iridia-ulb/drone-pcb/manufacturing/May2021/drone-bill-of-materials.xlsx

Part | Value | Device | Package | Description | Description2 | Qty | Place_YES/NO | Povided_by_customer_YES/NO | Distributor | Ordernumber | Weblink | Remarks_customer | Unit_price | Total_price | REMARKS_BETA | OPTION1 | OPTION2 | OPTION3
U13 | - | SN74LV4T125PWR | 14-TSSOP | Integrated Circuit | - | 1 | YES | NO | Digikey | 296-40545-1-ND
U9 | - | MIC803-30D4VM3-TR | SOT-23-3 | Integrated Circuit | - | 1 | YES | NO | Digikey | 576-3812-1-ND
X1 | 25 MHz | ASCO-25.000MHZ-EK-T3 | - | Integrated Circuit | - | 1 | YES | NO | Digikey | 535-12075-1-ND
U1 | - | USB4715T-I/Y9X | 48-VQFN | Integrated Circuit | - | 1 | YES | NO | Digikey | USB4715T-I/Y9XCT-ND
C70,C47,C46,C45,C44,C43,C38,C37,C35,C1,C2,C40,C39,C41,C61,C58,C3,C57,C59,C60,C21,C20,C19,C49,C69,C68,C66,C65,C48,C15,C50,C13,C11,C9,C7 | 100n | Generic | C0805 | Chip Capacitor | - | 35 | YES | NO | BetaLAYOUT stock | 100n, 50V, X7R
Q10,Q3,Q11,Q7,Q9,Q4,Q8,Q2,Q6,Q5,Q1 | - | BSS138DWQ-7 | SOT363 | MOSFET | - | 11 | YES | NO | Digikey | BSS138DWQ-7DICT-ND
R2,R44,R43,R40,R1,R81,R80,R4,R76,R75,R29,R34,R30,R31,R32,R33,R3,R5,R6,R7,R8,R63,R65,R12,R10,R16,R14,R46,R61,R15,R13,R11,R9,R38,R36 | 10k | Generic | R0805 | Chip Resistor | - | 35 | YES | NO | BetaLAYOUT stock | 10k, 1%
R84,R83,R82 | 4k7 | Generic | R0805 | Chip Resistor | - | 3 | YES | NO | BetaLAYOUT stock | 4k7, 1%
R42,R41,R37 | 200k | Generic | R0805 | Chip Resistor | - | 3 | YES | NO | BetaLAYOUT stock | 200k, 1%
R39 | 12k,1% | Generic | R0805 | Chip Resistor | - | 1 | YES | NO | BetaLAYOUT stock | 12k, 1%
FB1 | 120R | MMZ2012R121AT000 | R0805 | Ferrite Bead | - | 1 | YES | NO | Digikey | 445-2190-1-ND
C36,C34,C62,C31,C55,C54,C5,C4,C18,C17,C16,C28,C53,C52,C26,C24,C33,C27,C30,C29,C32,C23,C25,C67,C64,C63,C22 | 1u | Generic | C0805 | Chip Capacitor | - | 27 | YES | NO | BetaLAYOUT stock | 1u, 25V, X7R
U10 | - | TPS2054BD | 16-SOIC | Integrated Circuit | - | 1 | YES | NO | Digikey | 296-34586-5-ND
J16,J12,J8,J4 | - | SM05B-SRSS-TB(LF)(SN) | - | Header | - | 4 | YES | NO | Digikey | 455-1805-1-ND
U2 | - | PCA9554D,118 | 16-SOIC | Integrated Circuit | - | 1 | YES | NO | Digikey | 568-11911-1-ND
C42,C56,C6,C51,C14,C12,C10,C8 | 10u | Generic | C0805 | Chip Capacitor | - | 8 | YES | NO | BetaLAYOUT stock | 10u, 16V, X5R
R79,R77 | 6k8 | Generic | R0805 | Chip Resistor | - | 2 | YES | NO | BetaLAYOUT stock | 6k8, 1%
R78,R45 | 5k6 | Generic | R0805 | Chip Resistor | - | 2 | YES | NO | BetaLAYOUT stock | 5k6, 1%
D16 | Orange | APT3216SECK | - | SMD LED | - | 1 | YES | NO | Digikey | 754-1140-1-ND
D15 | Yellow | APT3216SYCK | - | SMD LED | - | 1 | YES | NO | Digikey | 754-1144-1-ND
D17 | Green | APT3216ZGC | - | SMD LED | - | 1 | YES | NO | Digikey | 754-1440-1-ND
D14 | Blue | APT3216VBC/D | - | SMD LED | - | 1 | YES | NO | Digikey | 754-1799-1-ND
D13 | Red | APTR3216SECK/J3-PRV | - | SMD LED | - | 1 | YES | NO | Digikey | 754-APTR3216SECK/J3-PRVCT-ND
U16 | - | CMX60D20 | - | Relay | - | 1 | YES | NO | Mouser | 558-CMX60D20
P1 | - | AXK5S00347YG | - | Socket | - | 1 | YES | NO | Digikey | 255-4198-1-ND
U18 | - | NPPC062KFMS-RC | - | Header | - | 1 | YES | NO | Digikey | S5715-ND
J17 | - | SM06B-GHS-TB(LF)(SN) | - | Header | - | 1 | YES | NO | Digikey | 455-1568-1-ND
S1 | - | ES02MSABE | - | Switch | - | 1 | YES | NO | Digikey | CKN1813CT-ND
R58,R56,R74,R73,R55,R53,R51,R60,R54,R57,R59,R50,R52,R72,R71,R70,R69,R49 | 0R | Generic | R0805 | Chip Resistor | - | 18 | YES | NO | BetaLAYOUT stock | 0, 1%
J18 | - | XT60-F | - | Connector | - | 1 | YES | NO | TME | XT60-F | https://www.tme.eu/en/details/xt60-f/dc-power-connectors/amass/
J20A,J20B | - | NPPN101BFLC-RC | - | Header | - | 2 | YES | NO | Digikey | S5901-10-ND
D12,D9,D6,D3 | Red | C503B-RAN-CZ0C0AA1 | - | Through-hole LED | - | 4 | YES | NO | Digikey | C503B-RAN-CZ0C0AA1-ND
D11,D8,D5,D2 | Green | C503B-GAN-CB0F0791 | - | Through-hole LED | - | 4 | YES | NO | Digikey | C503B-GAN-CB0F0791-ND
D10,D7,D4,D1 | Blue | C503B-BAN-CY0C0461 | - | Through-hole LED | - | 4 | YES | NO | Digikey | C503B-BAN-CY0C0461-ND
J9,J15,J14,J13,J11,J10,J7,J6,J5,J3,J2,J1 | - | 7-188275-8 | - | Receptacle | - | 12 | YES | NO | Digikey | A99475CT-ND
U3 | - | 24LC32AF-I/SN | 8-SOIC | Integrated Circuit | - | 1 | YES | NO | Digikey | 24LC32AF-I/SN-ND
R68 | 100k | Generic | R0805 | Chip Resistor | - | 1 | YES | NO | BetaLAYOUT stock | 100k, 1%
J19 | - | XT90PW-M | - | Connector | - | 1 | YES | NO | TME | XT90PW-M | https://www.tme.eu/en/details/xt90pw-m/dc-power-connectors/amass/
R20,R27,R26,R24,R23,R21,R18,R17 | 100R | Generic | R0805 | Chip Resistor | - | 8 | YES | NO | BetaLAYOUT stock | 100, 1%
U5 | - | PCA9635PW/Q900,118 | 28-TSSOP | Integrated Circuit | - | 1 | YES | NO | Digikey | 568-5930-1-ND
U17 | - | TLV70218DBVT | SOT-23-5 | Integrated Circuit | - | 1 | YES | NO | Digikey | 296-27889-1-ND
U4 | - | SN74LVC2G14DBVRG4 | SOT-23-6 | Integrated Circuit | - | 1 | YES | NO | Digikey | 296-35955-1-ND
SW2,SW1 | - | B3FS-1012P | - | Push button | - | 2 | YES | NO | Digikey | SW1237CT-ND
R47 | 15.4k | Generic | R0805 | Chip Resistor | - | 1 | YES | NO | Digikey | 311-15.4KCRCT-ND
U8,U7,U6 | - | PCA9544ADWR | 20-SOIC | Integrated Circuit | - | 3 | YES | NO | Digikey | 296-20958-6-ND
R64,R66 | 130R | Generic | R0805 | Chip Resistor | - | 2 | YES | NO | BetaLAYOUT stock | 130, 1%
R67 | 18R | Generic | R0805 | Chip Resistor | - | 1 | YES | NO | BetaLAYOUT stock | 18, 1%
U15 | - | TLV75528PDBV | SOT-23-5 | Integrated Circuit | - | 1 | YES | NO | Digikey | 296-51798-1-ND
U20,U19 | - | NC7SZ157P6X | SC-88 | Integrated Circuit | - | 2 | YES | NO | Digikey | NC7SZ157P6XCT-ND
R48 | 120R | Generic | R0805 | Chip Resistor | - | 1 | YES | NO | BetaLAYOUT stock | 120, 1%
R62 | 30R | Generic | R0805 | Chip Resistor | - | 1 | YES | NO | Digikey | RMCF0805FT30R0CT-ND
U12 | - | AP2281-3WG-7 | SOT-26 | Integrated Circuit | - | 1 | YES | NO | Digikey | AP2281-3WG-7DICT-ND
R28,R25,R22,R19 | 147R | Generic | R0805 | Chip Resistor | - | 4 | YES | NO | Digikey | 311-147CRCT-ND
U14 | - | NPPC051KFXC-RC | - | Header | - | 1 | YES | NO | Digikey | S5636-ND
