iridia-ulb/drone-pcb/manufacturing/March2020/BOM.xlsx

Part | Value | Device | Package | Description | Description2 | Qty | Place_YES/NO | Povided_by_customer_YES/NO | Distributor | Ordernumber | Weblink | Remarks_customer | Unit_price | Total_price | REMARKS_BETA | OPTION1 | OPTION2 | OPTION3
C2 C60 C1 C57 C59 C58 C62 C61 C3 C7 C9 C11 C13 C15 C21 C20 C19 C34 C41 C39 C40 C35 C43 C50 C48 C49 C44 C66 C65 C68 C69 | 100n, 50V, Z5U | Generic | C0805 | Chip Capacitor | - | 4 | YES | NO | BetaLayout Stock | 100n, 50V, Z5U
C36 C45 | 1n, 50V, C0G | Generic | C0805 | Chip Capacitor | - |  | YES | NO | BetaLayout Stock | 1n, 50V, C0G
C37 C46 | 4u7, 25V, X5R | Generic | C0805 | Chip Capacitor | - | 4 | YES | NO | BetaLayout Stock | 4u7, 25V, X5R
C5 C4 C24 C27 C30 C33 C23 C26 C29 C32 C22 C25 C28 C31 C18 C17 C16 C38 C47 C55 C54 C53 C52 C67 C64 C63 | 1u, 25V, X7R | Generic | C0805 | Chip Capacitor | - | 4 | YES | NO | BetaLayout Stock | 1u, 25V, X7R
C6 C56 C8 C10 C12 C14 C42 C51 | 10u, 16V, X5R | Generic | C0805 | Chip Capacitor | - | 4 | YES | NO | BetaLayout Stock | 10u, 16V, X5R
D1 D4 D7 D10 | Blue | C503B-BAN-CY0C0461 | - | Through-hole LED | - | 4 | YES | NO | Digikey | C503B-BAN-CY0C0461-ND
D13 | Red | APT3216SECK/J3-PRV | - | SMD LED | - | 4 | YES | NO | Digikey | 754-1796-1-ND
D14 | Blue | APT3216VBC/D | - | SMD LED | - | 4 | YES | NO | Digikey | 754-1799-1-ND
D15 | Yellow | APT3216SYCK | - | SMD LED | - | 4 | YES | NO | Digikey | 754-1144-1-ND
D16 | Orange | APT3216SECK | - | SMD LED | - | 4 | YES | NO | Digikey | 754-1140-1-ND
D17 | Green | APT3216ZGC | - | SMD LED | - | 4 | YES | NO | Digikey | 754-1440-1-ND
D2 D5 D8 D11 | Green | C503B-GAN-CB0F0791 | - | Through-hole LED | - | 4 | YES | NO | Digikey | C503B-GAN-CB0F0791-ND
D3 D6 D9 D12 | Red | C503B-RAN-CZ0C0AA1 | - | Through-hole LED | - | 4 | YES | NO | Digikey | C503B-RAN-CZ0C0AA1-ND
J1 J2 J3 J5 J6 J9 J10 J11 J13 J14 J15 J7 | - | 7-188275-8 | - | Receptacle | - | 4 | YES | NO | Digikey | A99475CT-ND
J12 J16 J4 J8 | - | SM05B-SRSS-TB | - | Receptacle | - | 4 | YES | NO | Digikey | 455-1805-1-ND
J17 | - | SM06B-GHS-TB | - | Receptacle | - | 4 | YES | NO | Digikey | 455-1568-1-ND
J18 | - | XT60PW-F | - | Connector | - | 4 | YES | YES | Supplied | -
J19 | - | XT90PW-M | - | Connector | - | 4 | YES | YES | Supplied | -
J20A, J20B | - | Xbee | - | Connectors for Xbee | - | 4 | YES | NO | Digikey | S5901-10-ND
P1 | - | Up Core | - | Connector for Upboard | - | 4 | YES | NO | Digikey | 255-4198-1-ND
Q2 Q3 Q1 Q5 Q4 Q7 Q6 Q8 Q9 | - | BSS138DW | - | Transistor | - | 4 | YES | NO | Digikey | BSS138DWQ-7DICT-ND
R17 R18 R20 R21 R23 R24 R26 R27 | 100R | Generic | R0805 | Chip Resistor | - | 4 | YES | NO | BetaLayout Stock | 100R, 1%
R19 R22 R25 R28 | 147R | Generic | R0805 | Chip Resistor | - | 4 | YES | NO | Digkey | 311-147CRCT-ND
R39 R42 | 0R | Generic | R0805 | Chip Resistor | - | 4 | NO | NO | Not Applicable | - |  | Do not place
R4 R3 R6 R8 R5 R7 R1 R2 R14 R16 R10 R12 R13 R15 R9 R11 R38 R36 R31 R32 R33 R34 R29 R30 R41 R35 R44 R37 R46 R61 R65 R63 | 10k | Generic | R0805 | Chip Resistor | - | 4 | YES | NO | BetaLayout Stock | 10k, 1%
R45 R40 R43 | 12k | Generic | R0805 | Chip Resistor | - | 4 | YES | NO | BetaLayout Stock | 12k, 1%
R47 | 15.4k | Generic | R0805 | Chip Resistor | - | 4 | YES | NO | Digikey | 311-15.4KCRCT-ND
R48 | 120R | Generic | R0805 | Chip Resistor | - | 4 | YES | NO | BetaLayout Stock | 120R, 1%
R62 | 30R | Generic | R0805 | Chip Resistor | - | 4 | YES | NO | Digkey | RMCF0805FT30R0CT-ND
R64 R66 | 130R | Generic | R0805 | Chip Resistor | - | 4 | YES | NO | BetaLayout Stock | 130R, 1%
R67 | 18R | Generic | R0805 | Chip Resistor | - | 4 | YES | NO | BetaLayout Stock | 18R, 1%
R68 | 100k | Generic | R0805 | Chip Resistor | - | 4 | YES | NO | BetaLayout Stock | 100k, 1%
R73 R74 R49 R50 R51 R54 R53 R52 R55 R58 R56 R59 R60 R57 R69 R70 R71 R72 | 0R | Generic | R0805 | Chip Resistor | - | 4 | YES | NO | BetaLayout Stock | 0R, 1%
S1 | - | ES02MSABE | - | Switch | - | 4 | YES | NO | Digikey | CKN1813CT-ND
SW2 SW1 | - | B3FS-1012P | - | Switch | - | 4 | YES | NO | Digikey | SW1237CT-ND
U10 | - | TPS2054BDR | 16-SOIC | Integrated Circuit | - | 4 | YES | NO | Digikey | 296-16988-6-ND
U12 | - | AP2281 | SOT-23-6 | Integrated Circuit | - | 4 | YES | NO | Digikey | AP2281-3WG-7DICT-ND
U13 | - | TXB0104DR | 14-SOIC | Integrated Circuit | - | 4 | YES | NO | Digikey | 296-21928-1-ND
U14 | - | D36V28F3 | - | Connector for external module | - | 4 | YES | NO | Digikey | S5597-ND
U15 | - | TLV75528PDBV | SOT-23-5 | Integrated Circuit | - | 4 | YES | NO | Digikey | 296-51798-1-ND
U16 | - | CMX60D20 | - | Integrated Circuit | - | 4 | YES | NO | Digikey | CC1666-ND
U17 | - | TLV75518PDBV | SOT-23-5 | Integrated Circuit | - | 4 | YES | NO | Digikey | 296-50410-1-ND
U18 | - | D36V50F5 | - | Connector for external module | - | 4 | YES | NO | Digikey | S5715-ND
U19 U20 | - | NC7SZ157 | SC-88 (SC-70-6) | Integrated Circuit | - | 4 | YES | NO | Digikey | NC7SZ157P6XCT-ND
U2 U1 | - | PCA9554D,118 | SOIC-16 | Integrated Circuit | - | 4 | YES | NO | Digikey | 568-11911-1-ND
U3 | - | 24LC32AF | SOIC-8 | Integrated Circuit | - | 4 | YES | NO | Digikey | 24LC32AF-I/SN-ND
U4 | - | SN74LVC2G14 | SOT-23-6 | Integrated Circuit | - | 4 | YES | NO | Digikey | 296-13010-1-ND
U5 | - | PCA9635PW | TSSOP-28 | Integrated Circuit | - | 4 | YES | NO | Digikey | 568-4067-1-ND
U6 U7 U8 | - | PCA9544ADWR | SOIC-20 | Integrated Circuit | - | 4 | YES | NO | Digikey | 296-20958-6-ND
U9 U11 | - | USB3503 | SQFN-32 | Integrated Circuit | - | 4 | YES | NO | Digikey | USB3503T-I/MLCT-ND
X1 X2 | - | ASTXR-12 | - | Oscillator | - | 4 | YES | NO | Digikey | 535-13192-1-ND
N1 | - | PH2-12-UA | - | Header | - | 4 | NO | YES | Digikey | 2057-PH2-12-UA-ND |  | Please order and ship with PCBs
N2 | - | TSW-105-08-T-S | - | Header | - | 4 | NO | YES | Digikey | SAM1050-05-ND |  | Please order and ship with PCBs
N3, N4, N5, N6, N7 | - | 971100244 | - | Standoff | - | 4 | NO | YES | Digikey | 732-12918-ND |  | Please order and ship with PCBs
N8, N9, N10, N11 | - | 971100154 | - | Standoff | - | 4 | NO | YES | Digikey | 732-12917-ND |  | Please order and ship with PCBs
N12, N13, N14, N15, N16 | - | 16M02050080 | - | Washer | - | 4 | NO | YES | Digikey | RPC10276-ND |  | Please order and ship with PCBs
N17, N18, N19, N20 | - | 16M02556080 | - | Washer | - | 4 | NO | YES | Digikey | RPC10206-ND |  | Please order and ship with PCBs
N21, N22, N23, N24, N25 | - | 04M020040HN | - | Nut | - | 4 | NO | YES | Digikey | RPC7084-ND |  | Please order and ship with PCBs
N26, N27, N28, N29 | - | 04M025045HN | - | Nut | - | 4 | NO | YES | Digikey | RPC7085-ND |  | Please order and ship with PCBs
N30 | - | XB2B-WFUT-001 | - | External Module | - | 4 | NO | YES | Digikey | 602-1378-ND |  | Please order and ship with PCBs
N31 | - | WRL-11697 | - | External Module | - | 4 | NO | YES | Digikey | 1568-1116-ND |  | Please order and ship with PCBs
