iridia-ulb/drone-pcb/board-outline.dxf

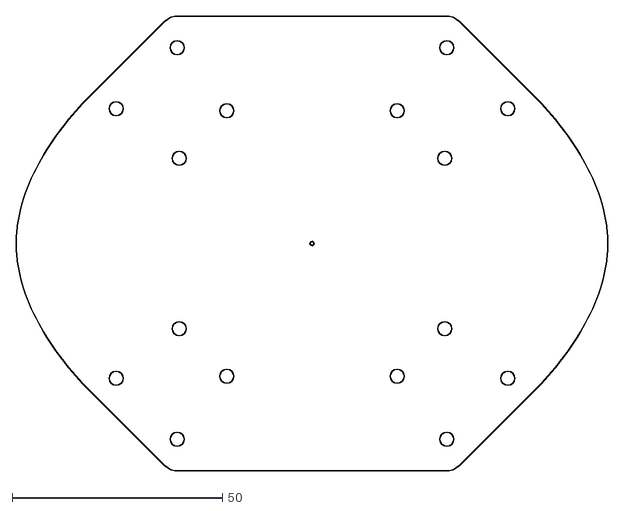
[picture p1: CAD file, 2020-02-24]
board-outline.dxf
140.6 x 108.1
