iridia-ulb/drone-pcb/models/asco.step

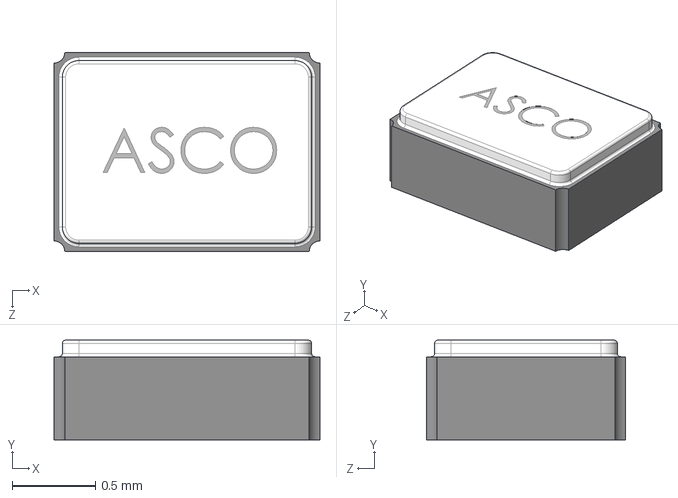
[picture p2: CAD file, 2021-05-06]
models/asco.step
1.60 x 0.6 x 1.20 mm
