iridia-ulb/drone-pcb/arms-outline.dxf

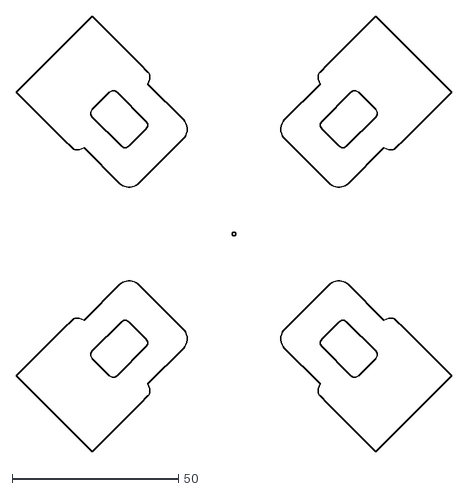
[picture p3: CAD file, 2020-02-24]
arms-outline.dxf
131.0 x 131.0
