iridia-ulb/drone-pcb/models/lower-components.step

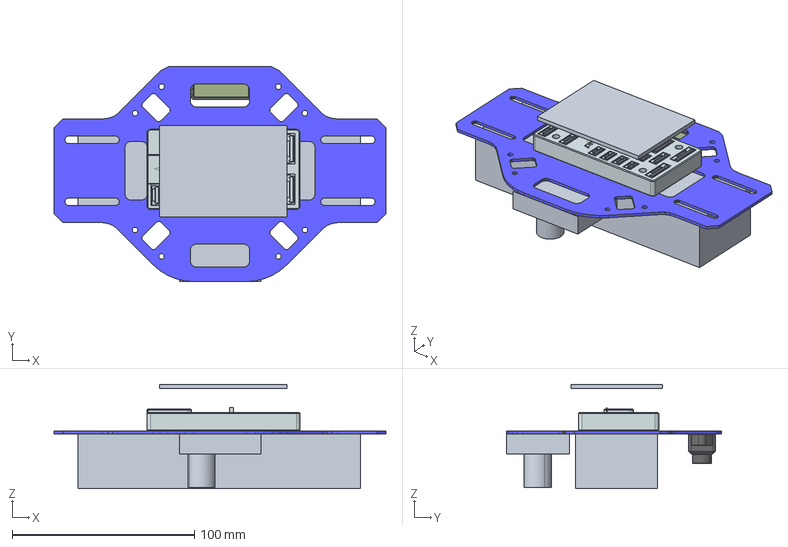
[picture p4: CAD file, 2020-03-05]
models/lower-components.step
182.0 x 118.1 x 57.0 mm
Block 15
Block 16
Block 17
Lente Grande
Lente Pequena
SM04B-GHS-TB
Chipset
Adesivo
Block 19
