iridia-ulb/drone-pcb/models/APT3216.step

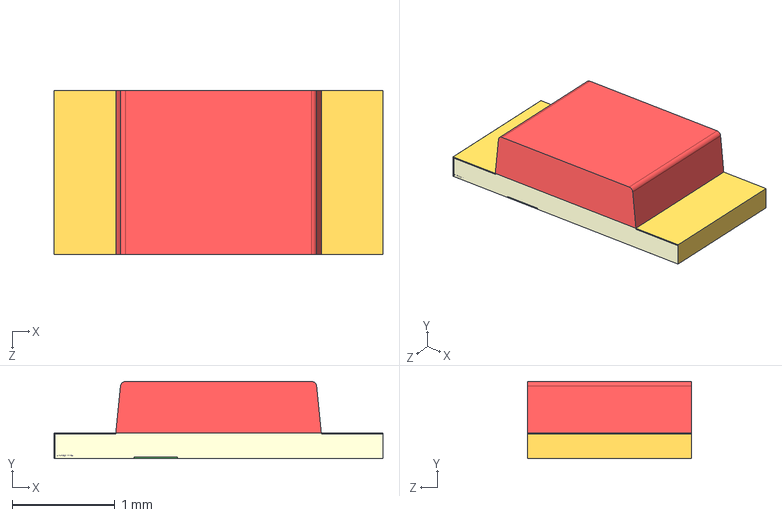
[picture p5: CAD file, 2020-03-03]
models/APT3216.step
3.20 x 0.75 x 1.60 mm
