iridia-ulb/drone-pcb/models/xbee.step

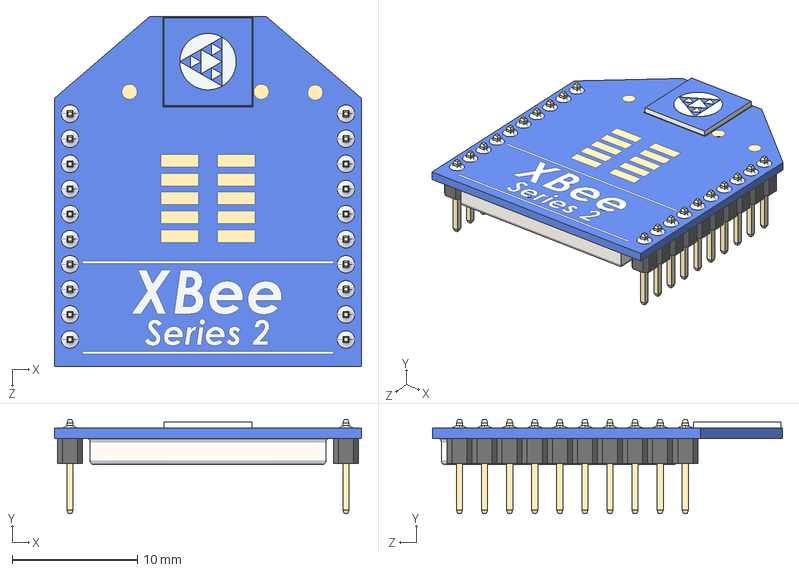
[picture p6: CAD file, 2020-02-28]
models/xbee.step
24.5 x 7.50 x 27.9 mm
XBee-10pin-male_1 x 2
XBee-Chip_1
XBee-Chip-antenna_1
