iridia-ulb/drone-pcb/models/NPPN101BFLC-RC.step

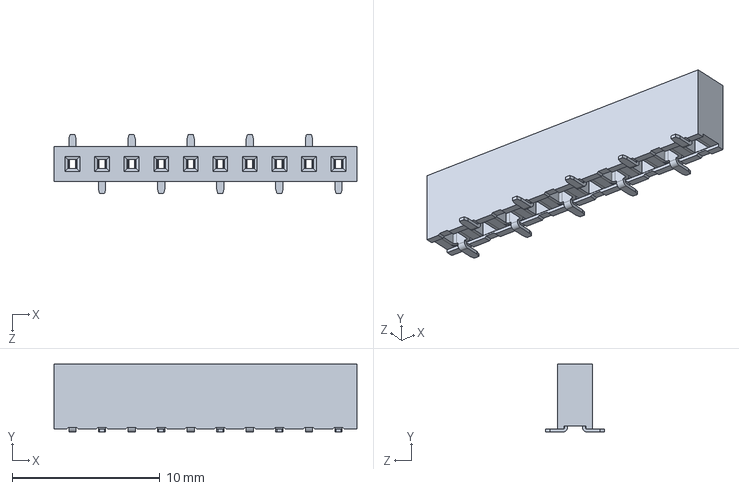
[picture p7: CAD file, 2020-02-28]
models/NPPN101BFLC-RC.step
20.5 x 4.60 x 4.00 mm
