iridia-ulb/drone-pcb/models/7-188275-8.step

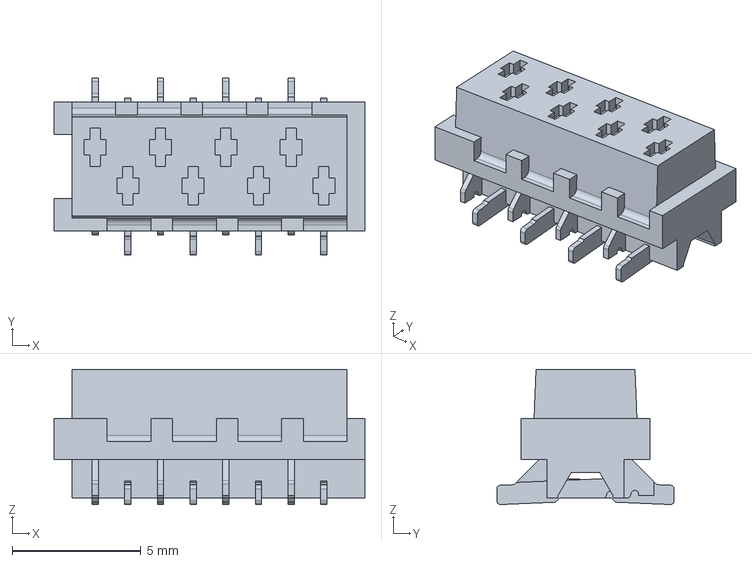
[picture p8: CAD file, 2020-02-25]
models/7-188275-8.step
12.1 x 6.90 x 5.25 mm
