iridia-ulb/drone-pcb/models/arms.step

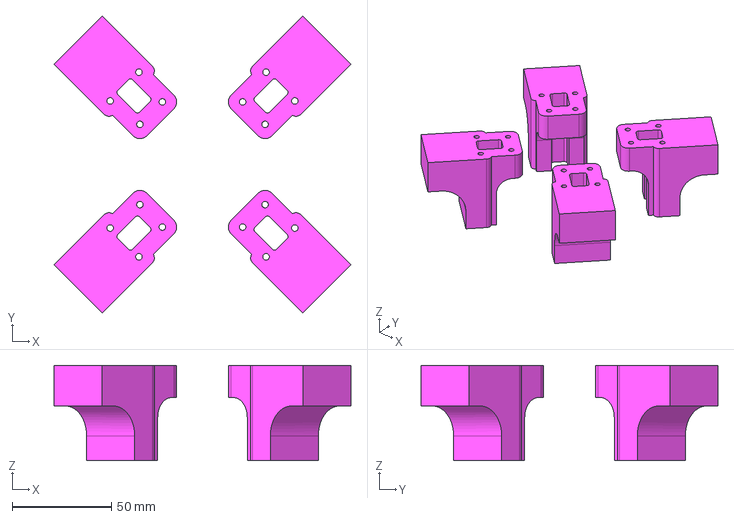
[picture p9: CAD file, 2020-02-24]
models/arms.step
149.6 x 149.6 x 48.0 mm
