iridia-ulb/drone-pcb/models/m2-spacer-10mm.step

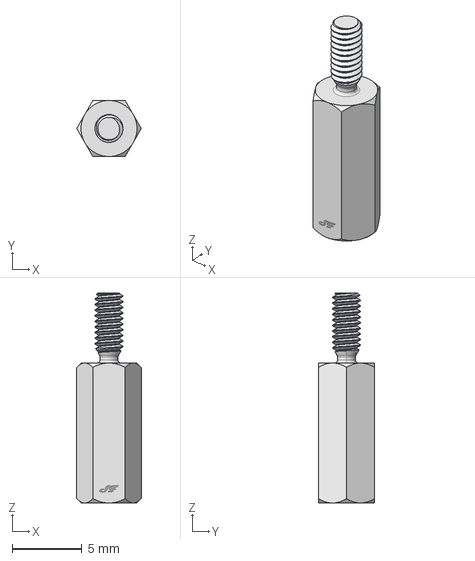
[picture p10: CAD file, 2020-02-21]
models/m2-spacer-10mm.step
4.62 x 4.00 x 15.0 mm
