iridia-ulb/drone-pcb/models/C503B.step

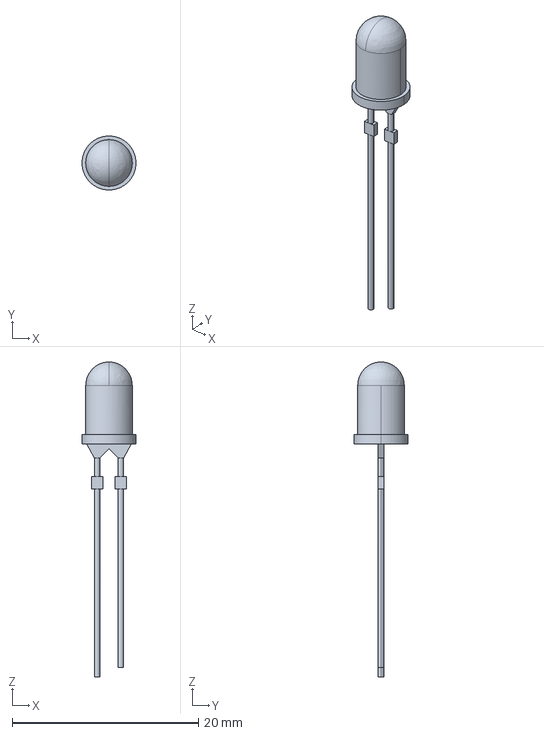
[picture p11: CAD file, 2020-02-19]
models/C503B.step
5.80 x 5.80 x 33.8 mm
