iridia-ulb/drone-pcb/models/sm07b-srss-tb.step

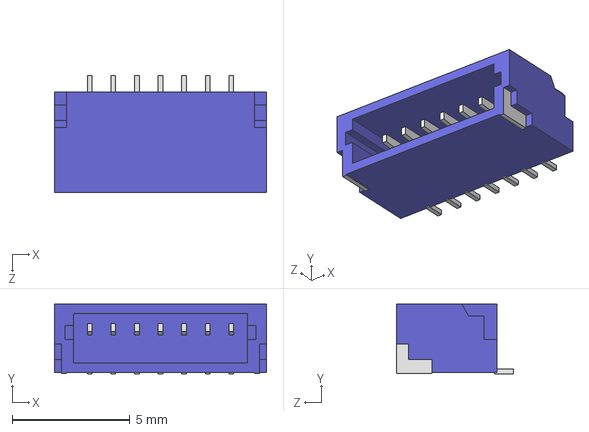
[picture p12: CAD file, 2020-02-18]
models/sm07b-srss-tb.step
9.00 x 2.96 x 4.95 mm
