iridia-ulb/drone-pcb/models/vl53l0x-and-vl53l1x-carrier-model.step

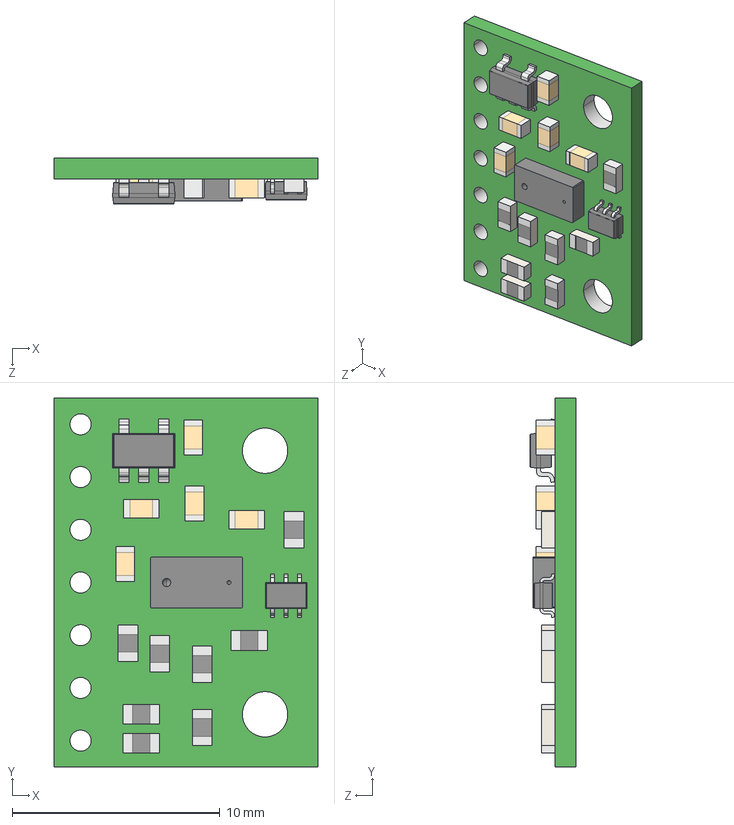
[picture p13: CAD file, 2020-02-18]
models/vl53l0x-and-vl53l1x-carrier-model.step
12.7 x 17.8 x 2.21 mm
