iridia-ulb/drone-pcb/models/m2.5hex9mm.stp

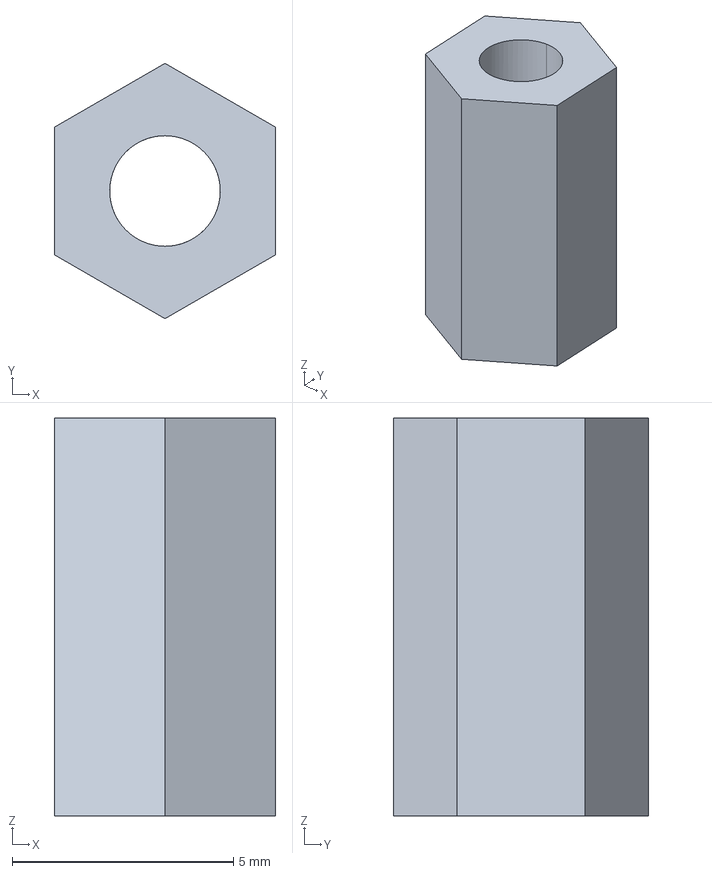
[picture p14: CAD file, 2020-02-18]
models/m2.5hex9mm.stp
5.00 x 5.77 x 9.00 mm
