iridia-ulb/drone-pcb/models/MSL04.step

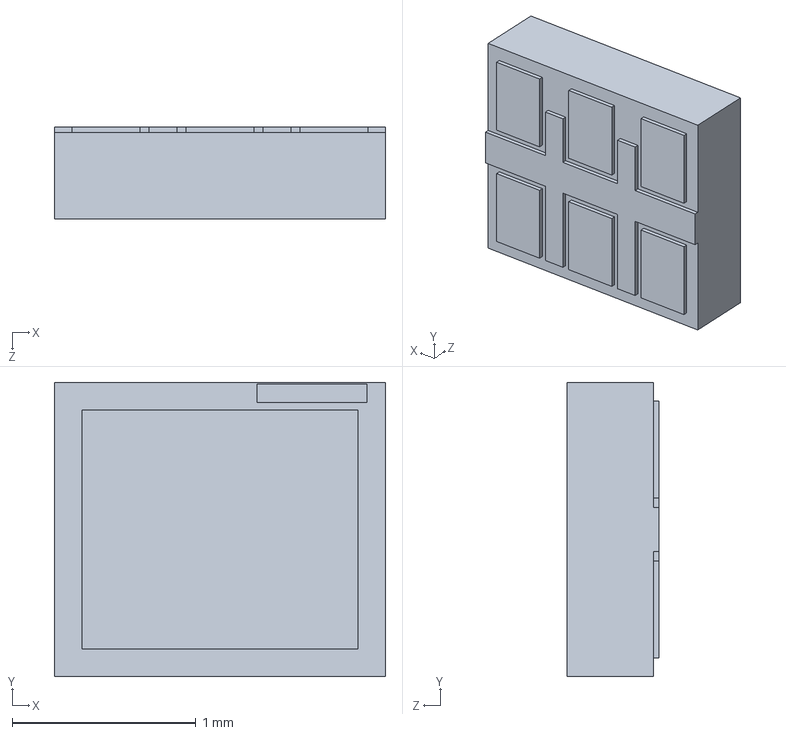
[picture p15: CAD file, 2020-02-14]
models/MSL04.step
1.80 x 1.60 x 0.5 mm
