iridia-ulb/drone-pcb/models/SM06B-GHS-TB.STEP

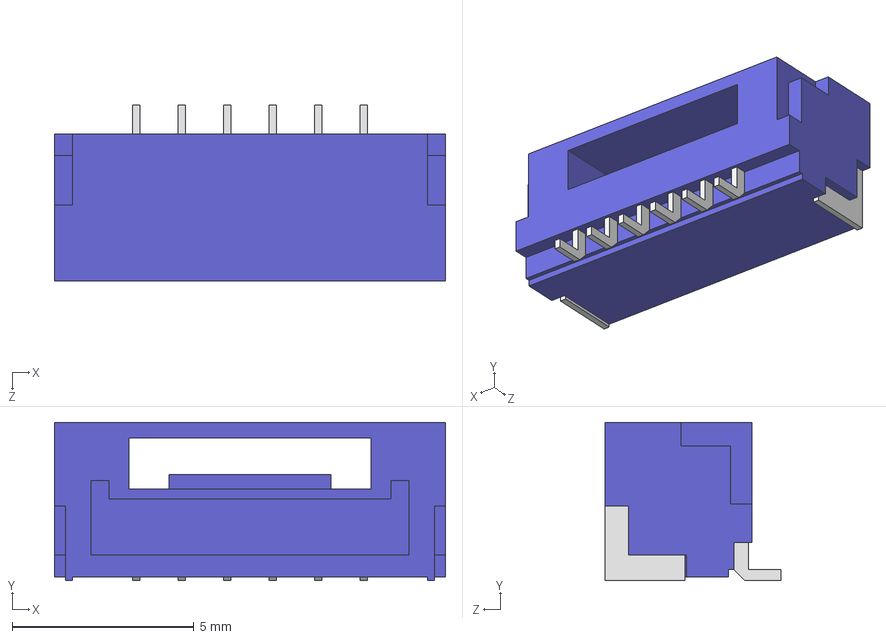
[picture p16: CAD file, 2020-02-13]
models/SM06B-GHS-TB.STEP
10.8 x 4.35 x 4.85 mm
