iridia-ulb/drone-pcb/models/BM06B-GHS-TBT.STEP

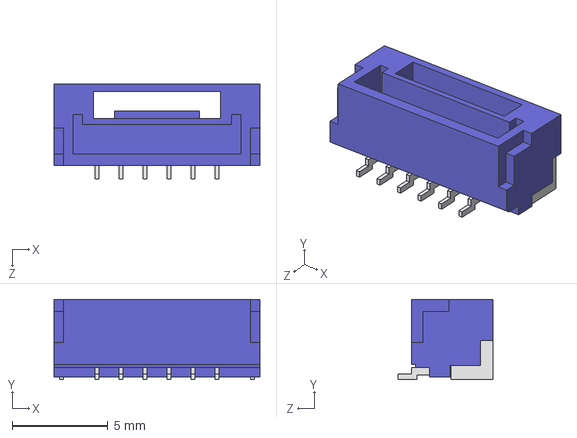
[picture p17: CAD file, 2020-02-13]
models/BM06B-GHS-TBT.STEP
10.8 x 4.20 x 4.95 mm
