iridia-ulb/drone-pcb/models/ES01MSABE.stp

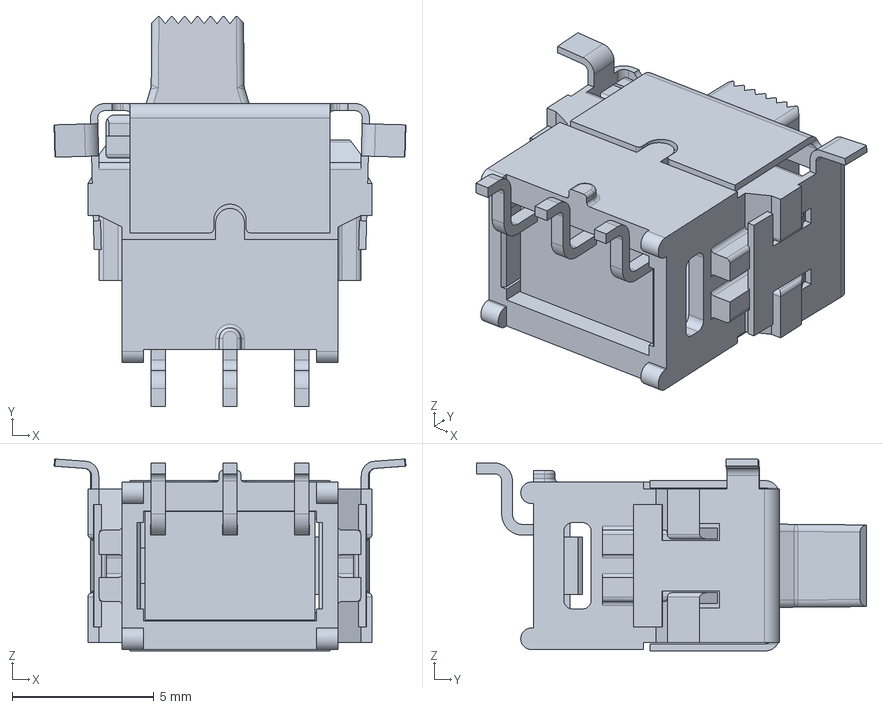
[picture p18: CAD file, 2020-02-12]
models/ES01MSABE.stp
12.4 x 13.8 x 6.78 mm
