iridia-ulb/drone-pcb/models/vertical-pin-socket-2x06.step

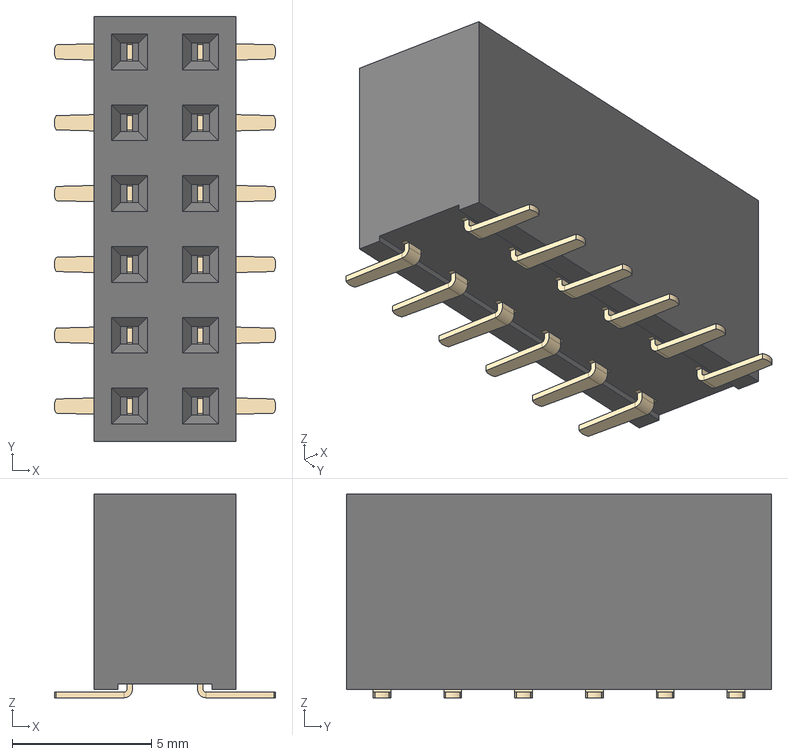
[picture p19: CAD file, 2020-02-11]
models/vertical-pin-socket-2x06.step
7.94 x 15.2 x 7.30 mm
