iridia-ulb/drone-pcb/models/vertical-pin-header-1x05.step

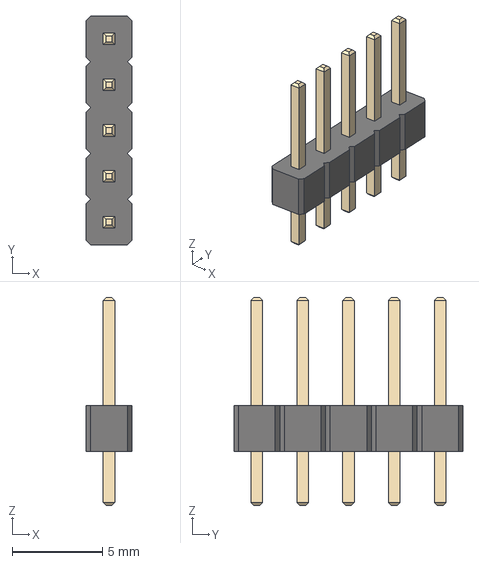
[picture p20: CAD file, 2020-02-11]
models/vertical-pin-header-1x05.step
2.54 x 12.7 x 11.5 mm
