iridia-ulb/drone-pcb/models/vertical-pin-socket-1x05.step

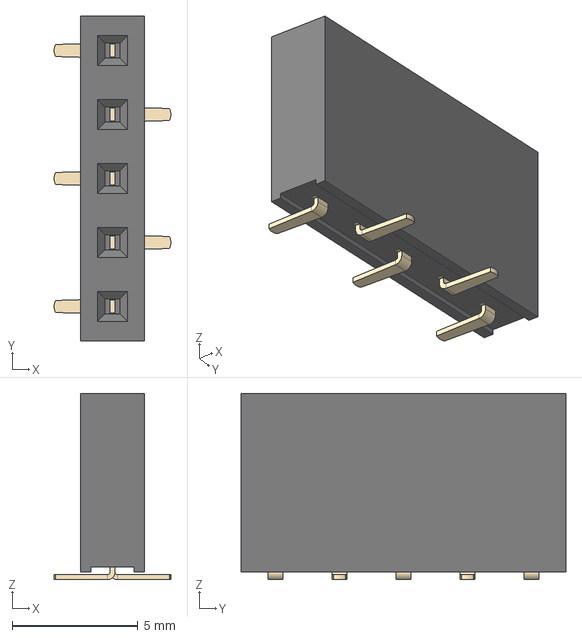
[picture p21: CAD file, 2020-02-11]
models/vertical-pin-socket-1x05.step
4.64 x 12.9 x 7.40 mm
