iridia-ulb/drone-pcb/models/vertical-pin-header-2x06.step

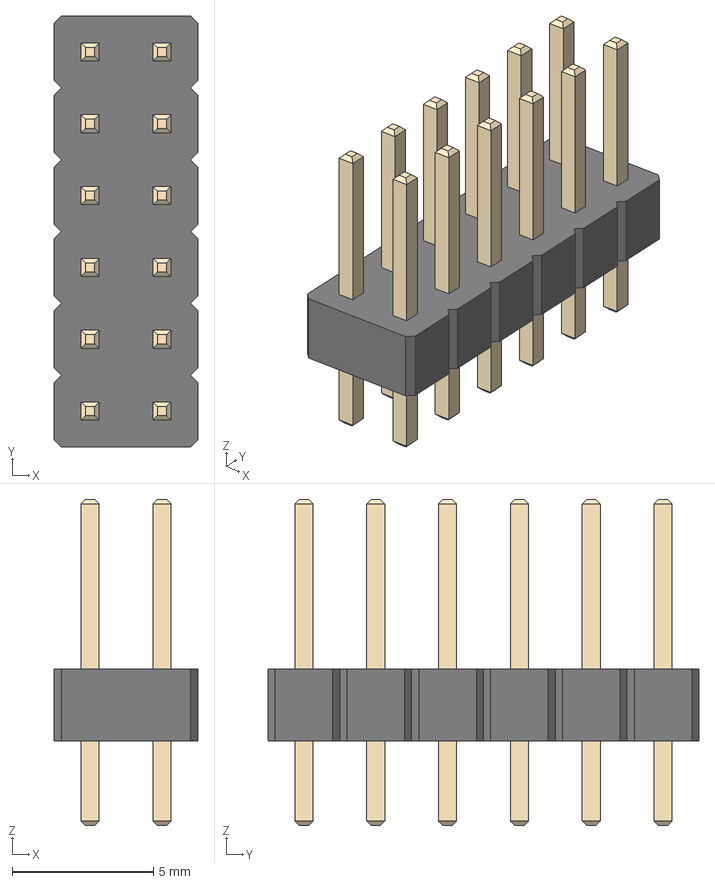
[picture p22: CAD file, 2020-02-11]
models/vertical-pin-header-2x06.step
5.08 x 15.2 x 11.5 mm
