iridia-ulb/drone-pcb/models/B3FS_1000.step

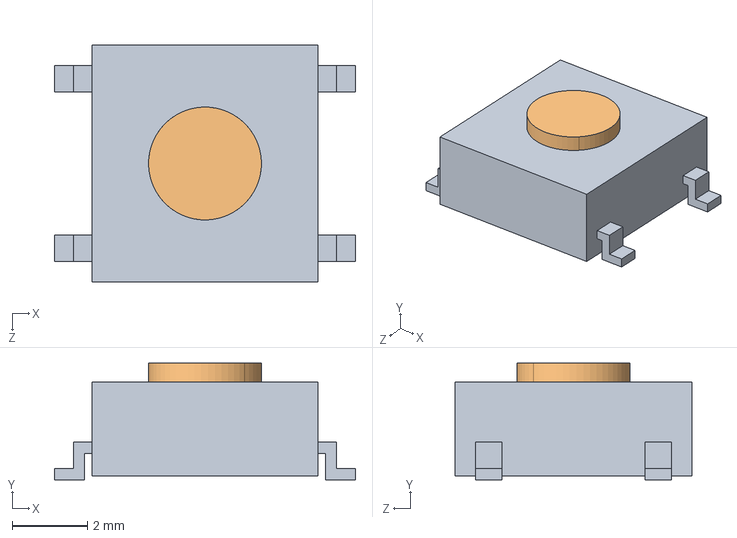
[picture p23: CAD file, 2020-02-10]
models/B3FS_1000.step
8.00 x 3.10 x 6.30 mm
B3FS_1000_BASE
B3FS_1000_BUTTON
