iridia-ulb/drone-pcb/models/axk5s00347y.stp

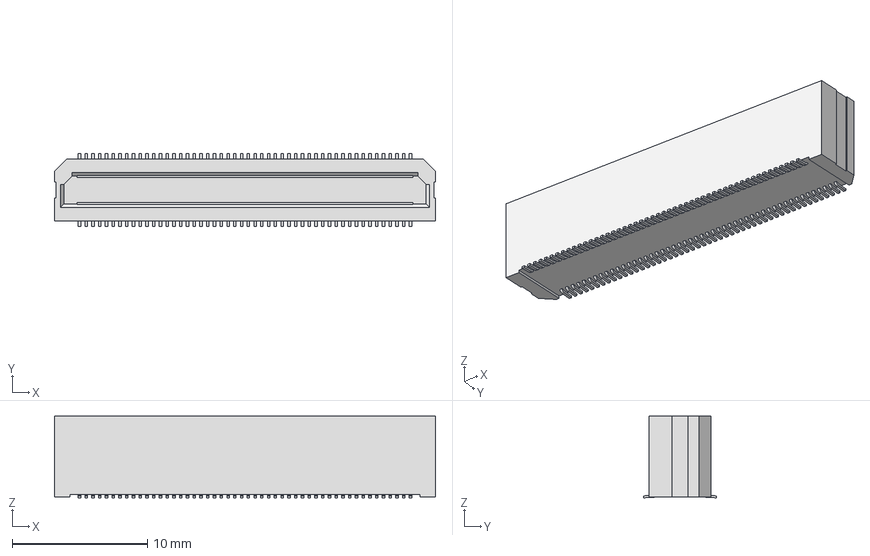
[picture p24: CAD file, 2020-02-10]
models/axk5s00347y.stp
28.2 x 5.40 x 6.05 mm
