iridia-ulb/drone-pcb/models/XT90PW-M.step

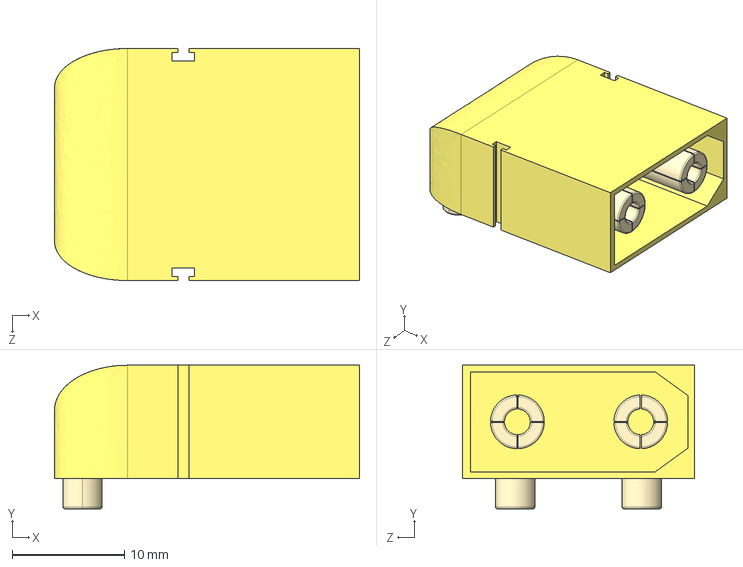
[picture p25: CAD file, 2020-02-05]
models/XT90PW-M.step
27.2 x 12.8 x 20.7 mm
