iridia-ulb/drone-pcb/models/CMX60D20.step

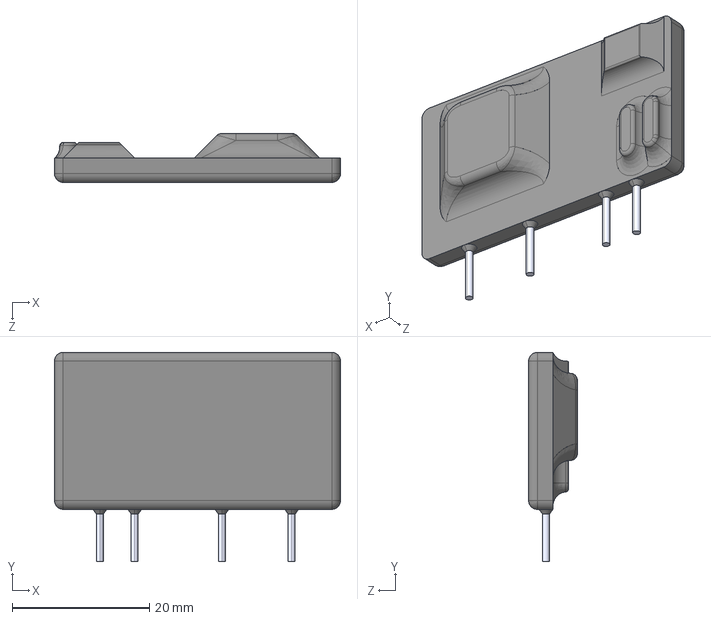
[picture p26: CAD file, 2020-02-05]
models/CMX60D20.step
41.7 x 30.5 x 7.11 mm
