iridia-ulb/drone-pcb/models/XT60-F.step

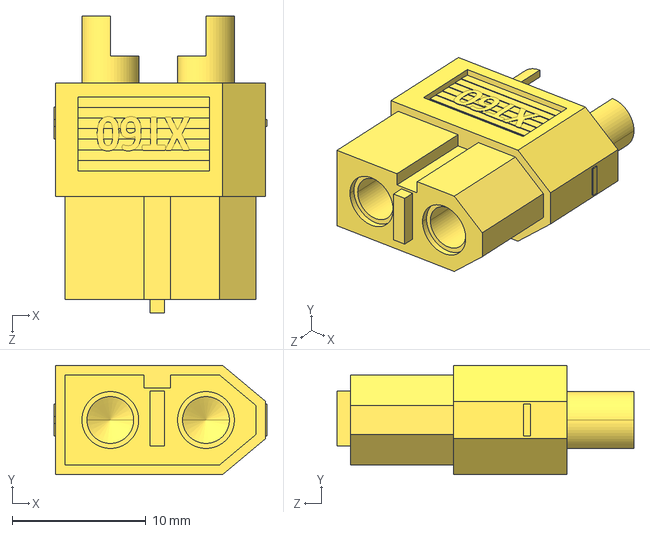
[picture p27: CAD file, 2020-02-05]
models/XT60-F.step
15.9 x 8.15 x 22.2 mm
