iridia-ulb/drone-pcb/models/sm05b-srss-tb.step

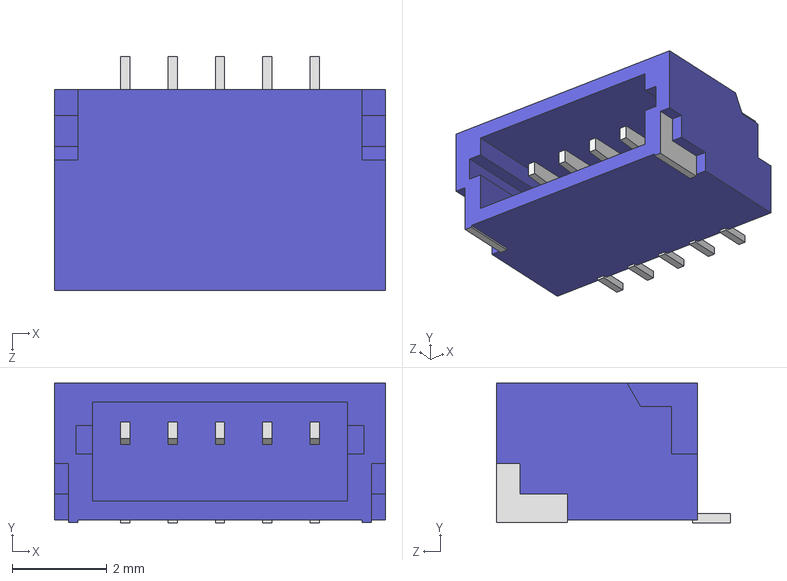
[picture p28: CAD file, 2020-01-28]
models/sm05b-srss-tb.step
7.00 x 2.96 x 4.95 mm
