iridia-ulb/drone-pcb/models/astxr-12.step

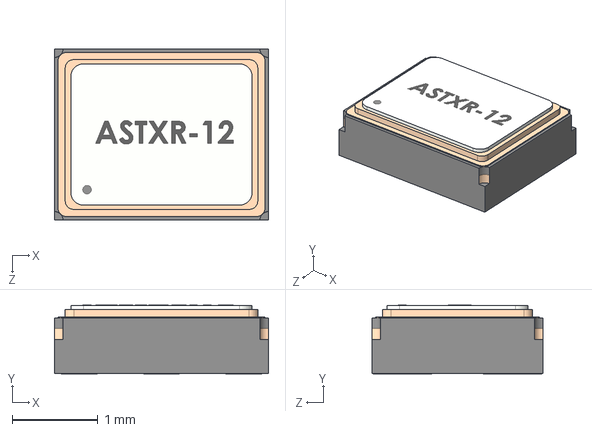
[picture p29: CAD file, 2020-01-28]
models/astxr-12.step
2.50 x 0.802 x 2.00 mm
