iridia-ulb/drone-pcb/(list of files, cad)

Other CAD files:
models/ES02MSABE.stp
models/bolt-assembly.step
