iridia-ulb/drone-pcb/manufacturing/May2021/drone-assembly-drawing-back.pdf

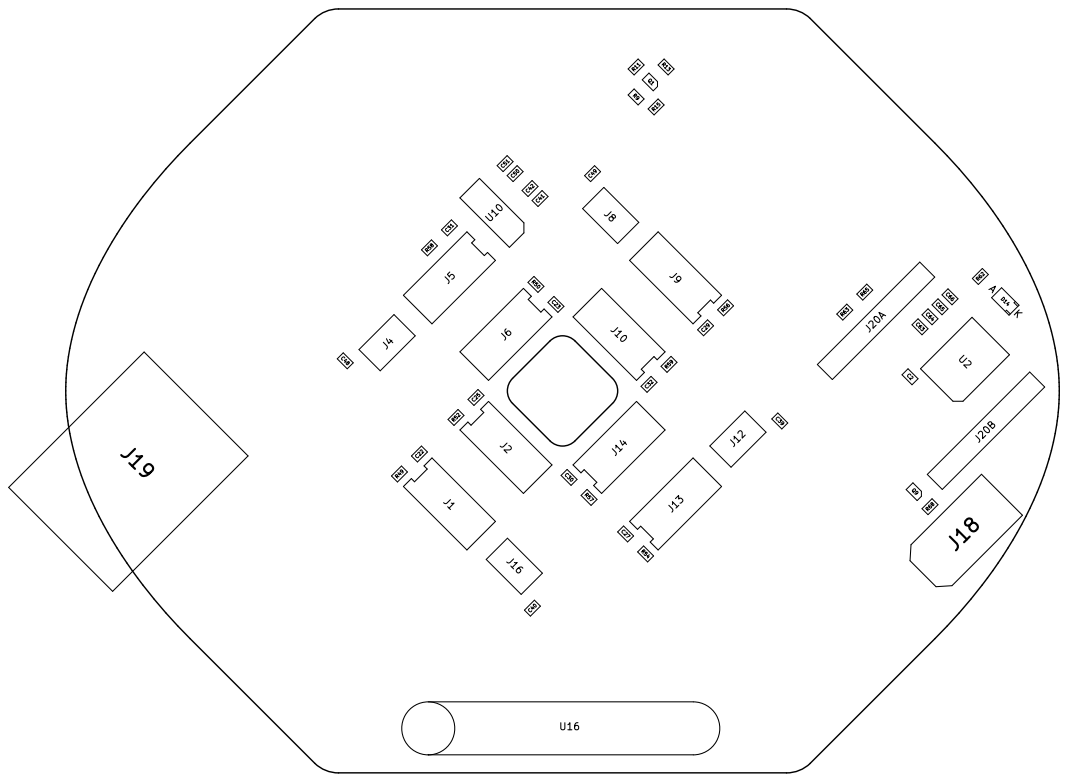
[picture p30: page 1]
