iridia-ulb/drone-pcb/manufacturing/May2021/drone-assembly-drawing-front.pdf

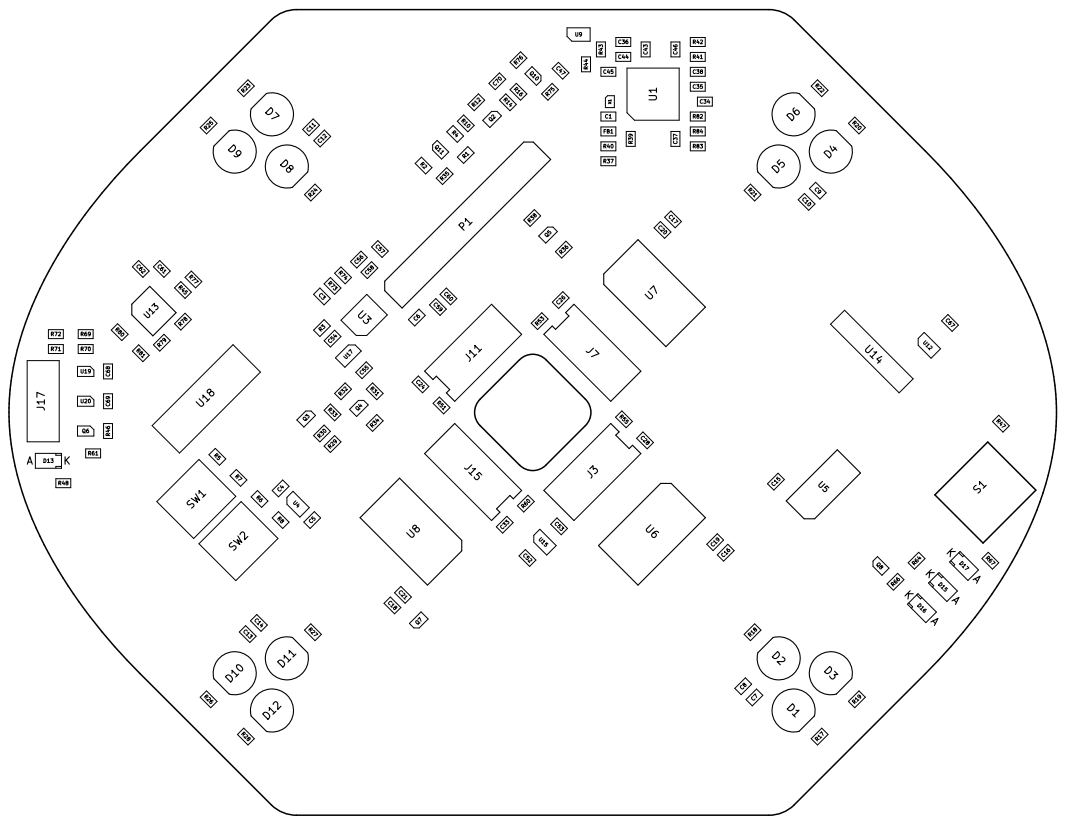
[picture p31: page 1]
