iridia-ulb/drone-pcb/manufacturing/March2020/assembly-drawing-back.pdf

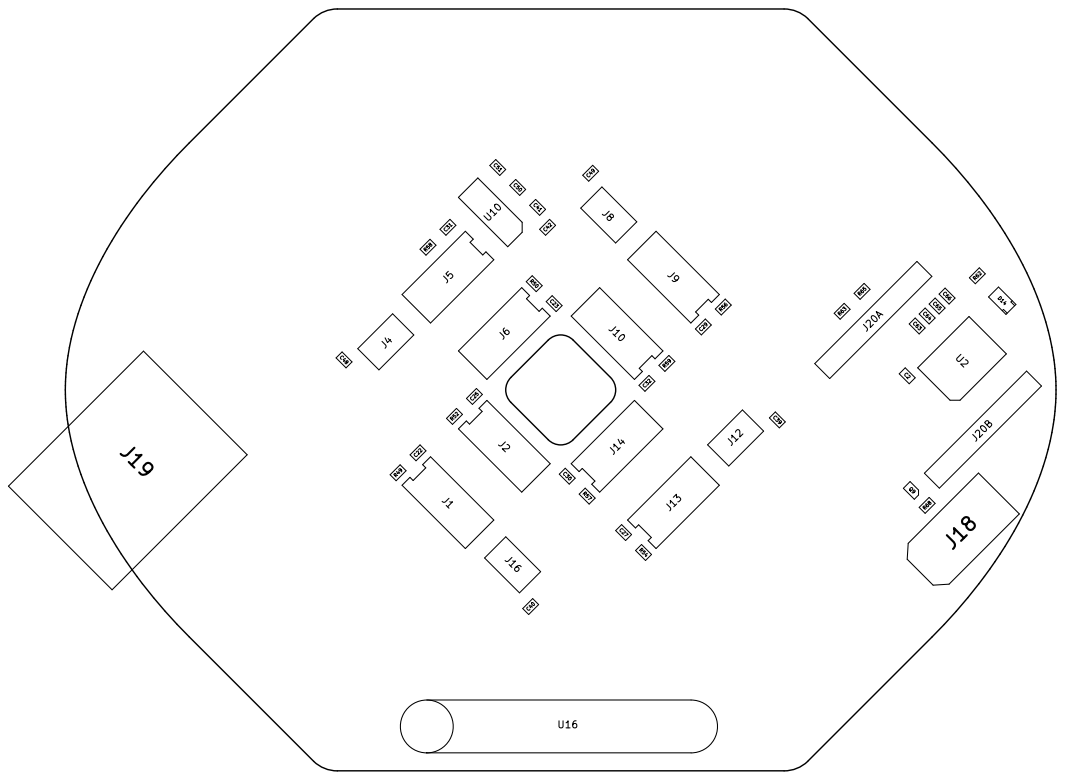
[picture p32: page 1]
