iridia-ulb/drone-pcb/manufacturing/March2020/assembly-drawing-front.pdf

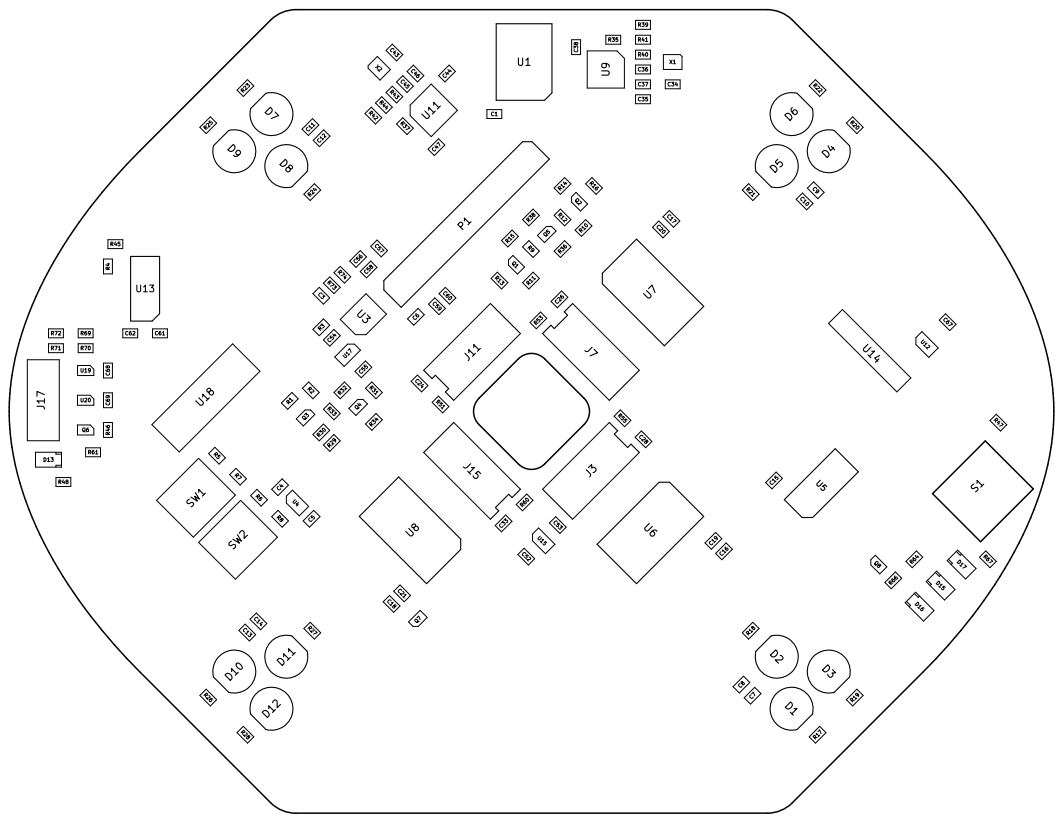
[picture p33: page 1]
