iridia-ulb/drone-pcb/cables/2837-000-01 - Cable, JST GHR-06V-S to JST GHR-06V-S, 100mm.pdf

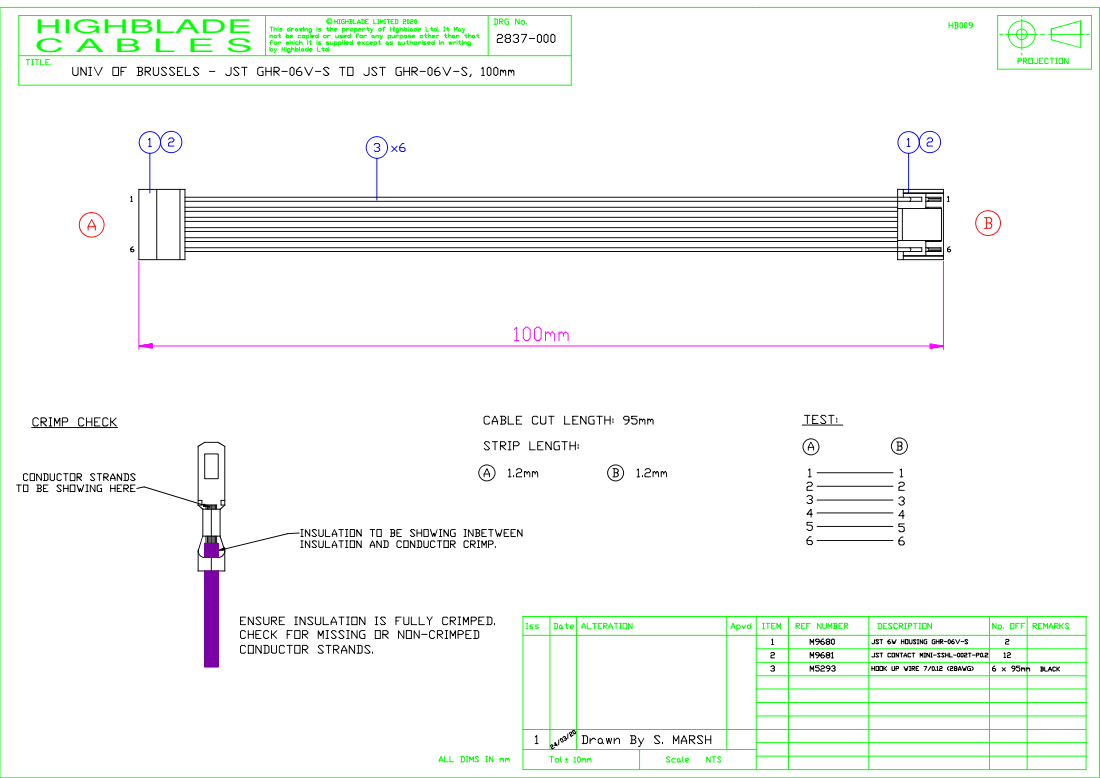
[picture p34: page 1]
HIGHBLADE C A B L E S
