iridia-ulb/drone-pcb/cables/2838-000-01 - Cable, JST GHR-04V-S to JST GHR-06V-S, 70mm.pdf

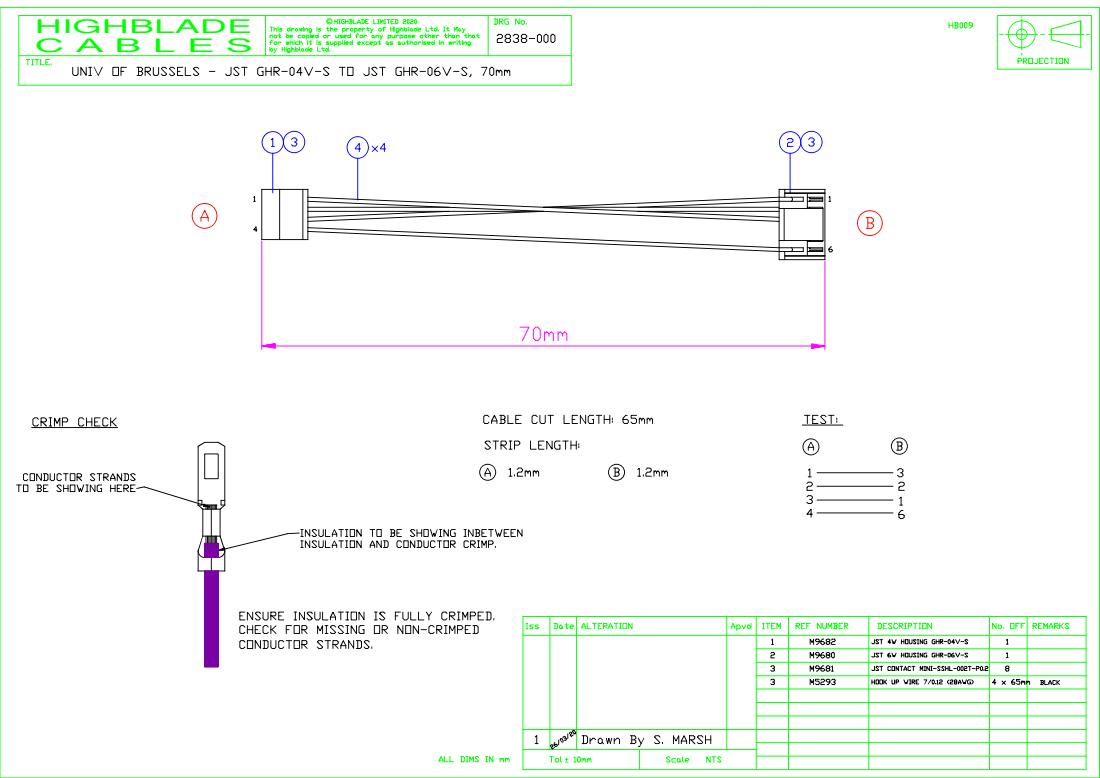
[picture p35: page 1]
HIGHBLADE C A B L E S
