iridia-ulb/drone-pcb/cables/2839-000-01 - Cable, TE 7-215083-8 to Molex 0022112072, 240mm.pdf

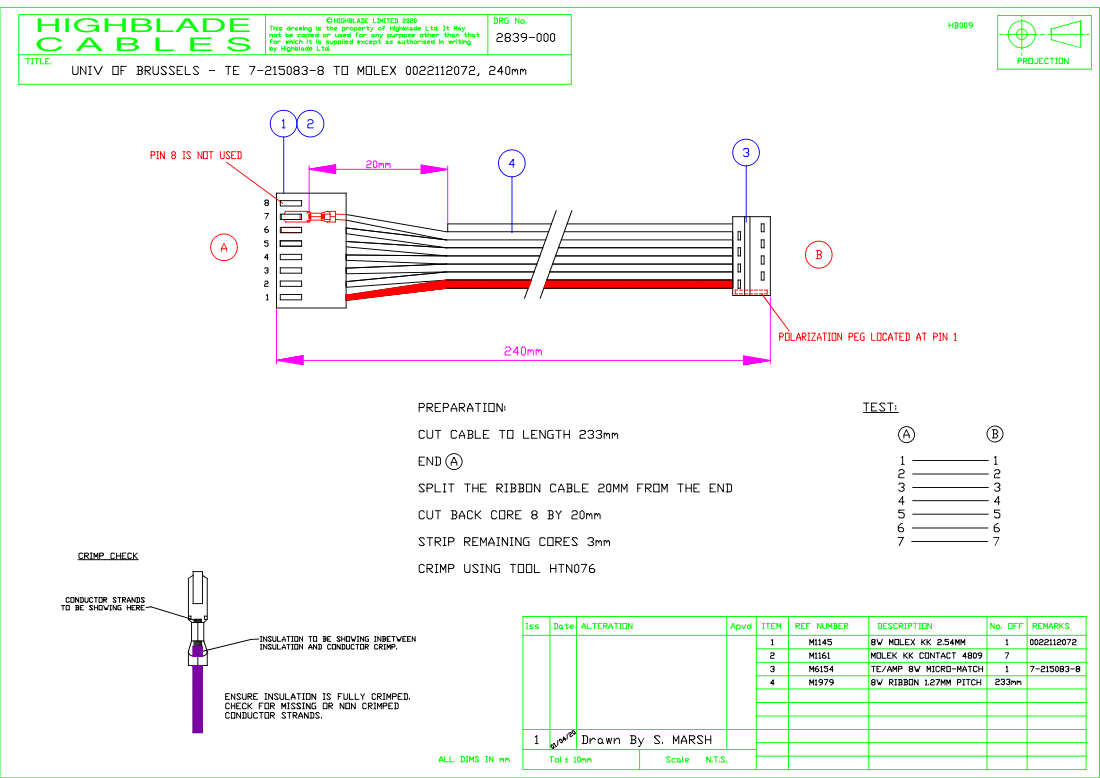
[picture p36: page 1]
HIGHBLADE C A B L E S
