iridia-ulb/drone-pcb/cables/2840-000-01 - Cable, TE 7-215083-8 to Molex 0022112072, 180mm.pdf

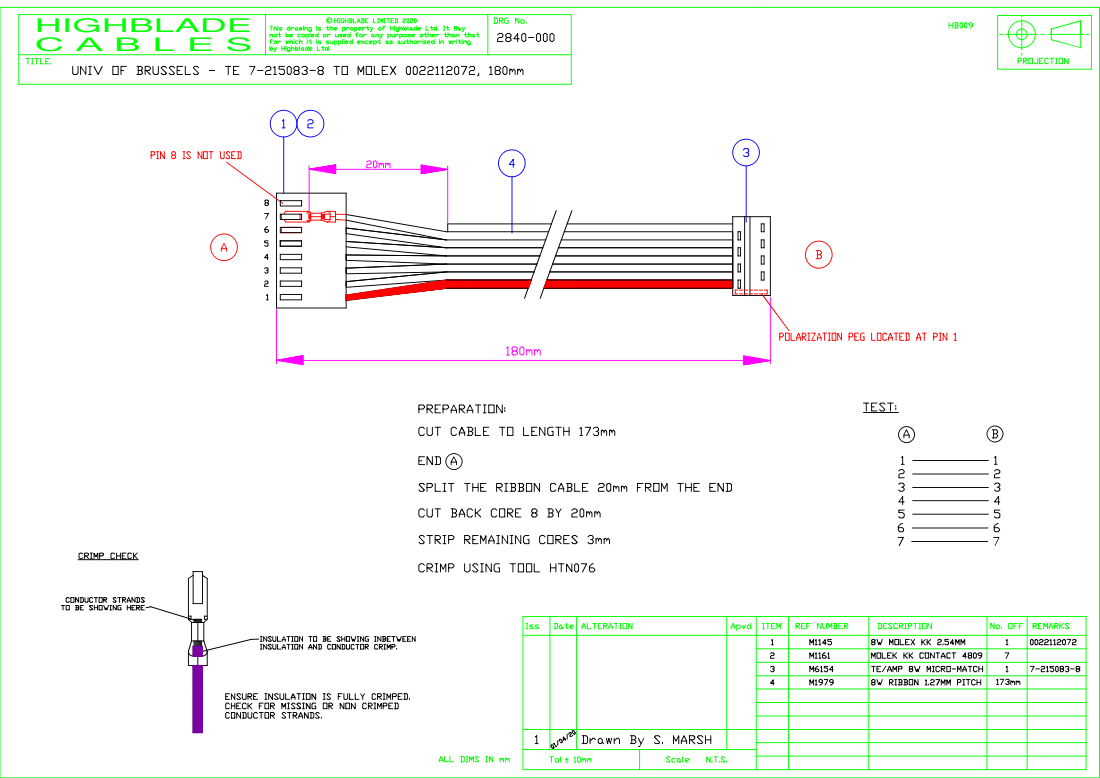
[picture p37: page 1]
HIGHBLADE C A B L E S
