iridia-ulb/drone-pcb/cables/2841-000-01 - Cable, JST SHR-05V-S.pdf

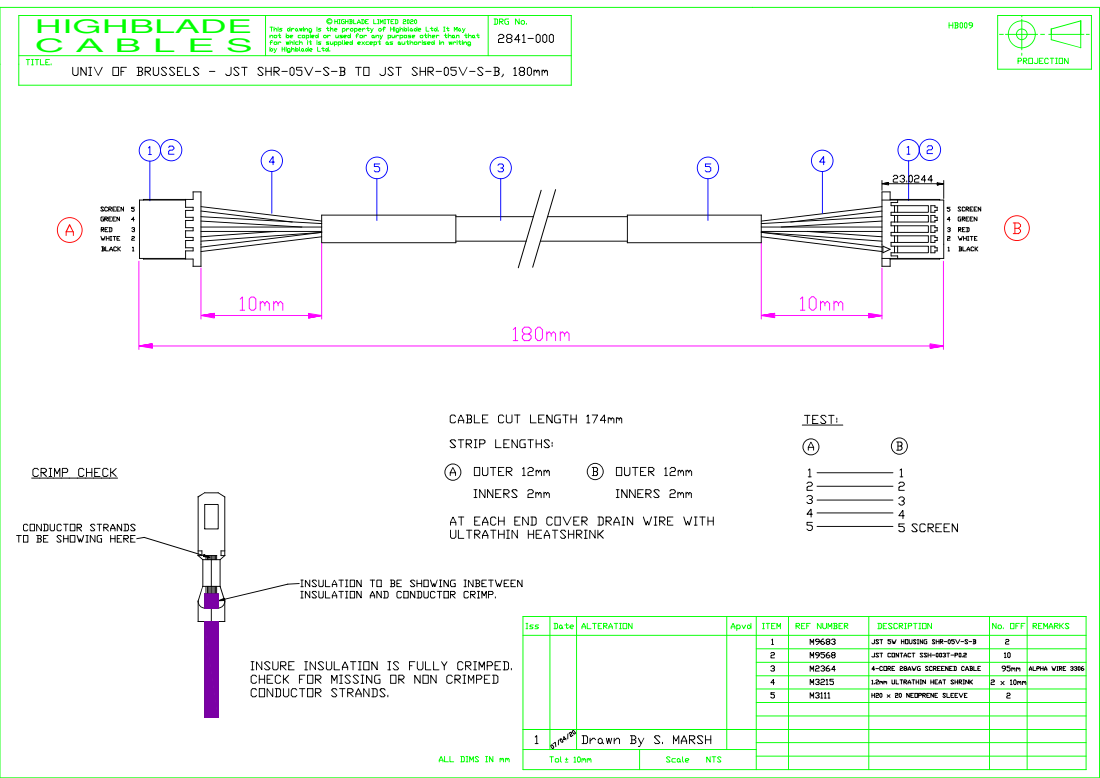
[picture p38: page 1]
HIGHBLADE C A B L E S
