iridia-ulb/drone-pcb/cables/2842-000-01 - Cable, JST SHR-04V-S-B to JST-GHR-04V-S, 70mm.pdf

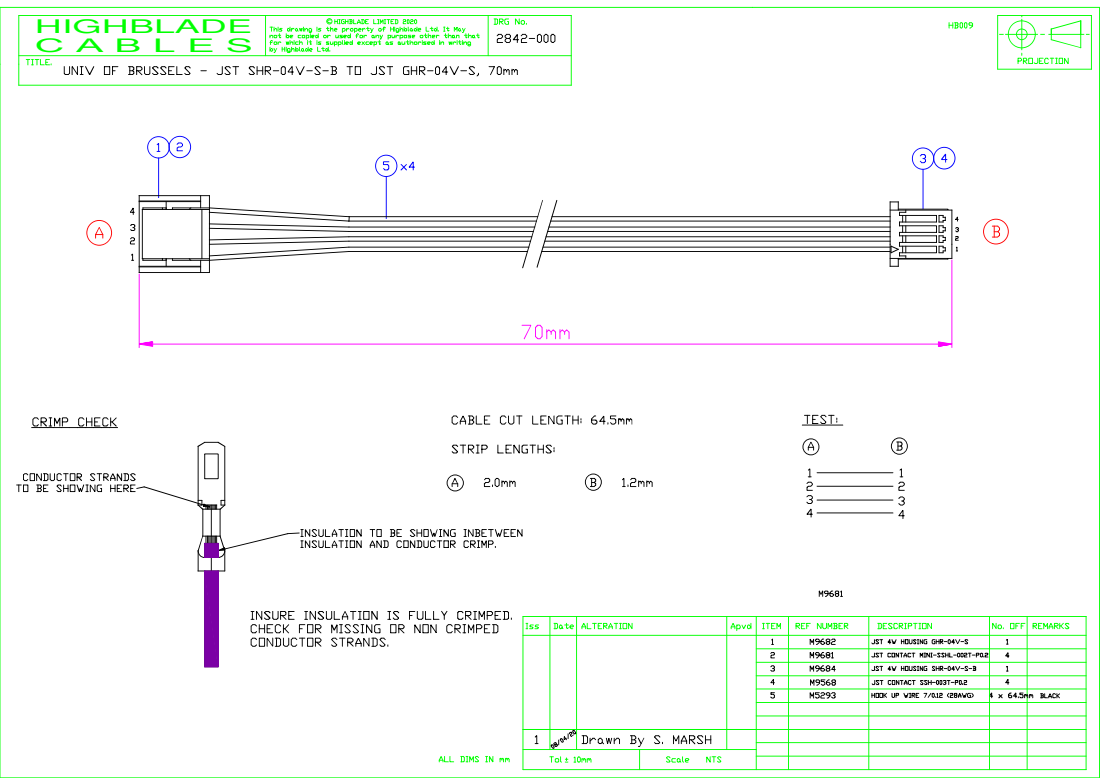
[picture p39: page 1]
HIGHBLADE C A B L E S
