iridia-ulb/drone-pcb/manufacturing/June2020/drone-assembly-drawing-back.pdf

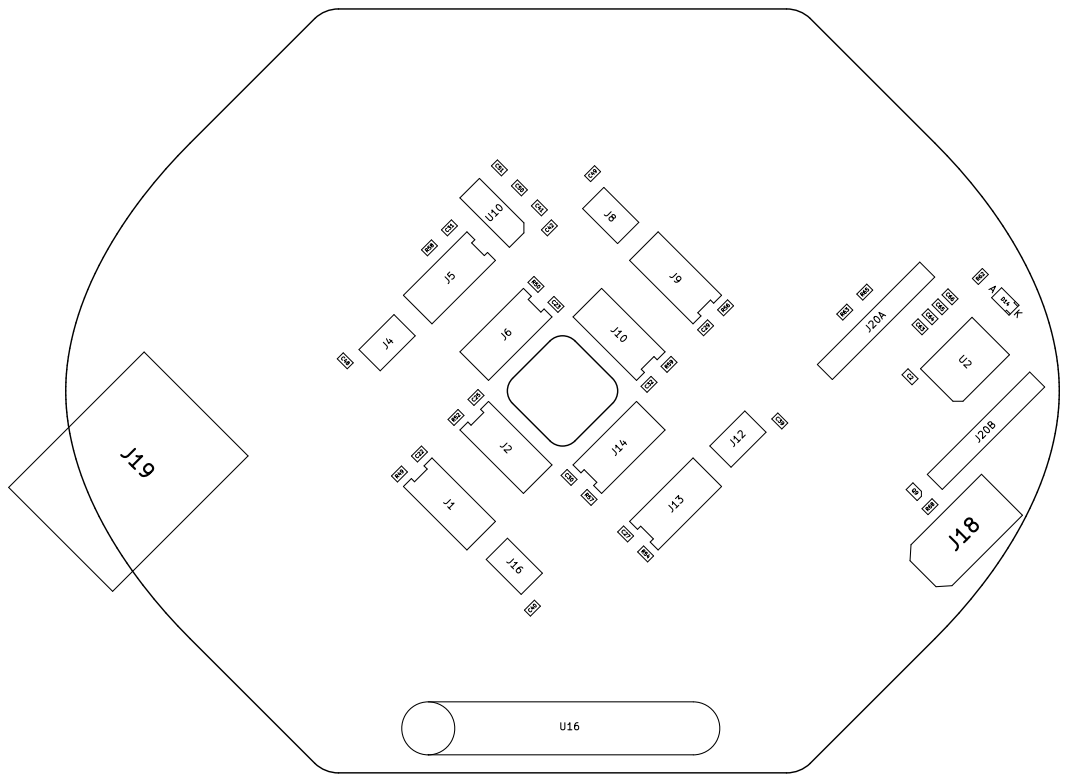
[picture p40: page 1]
