iridia-ulb/drone-pcb/manufacturing/June2020/drone-assembly-drawing-front.pdf

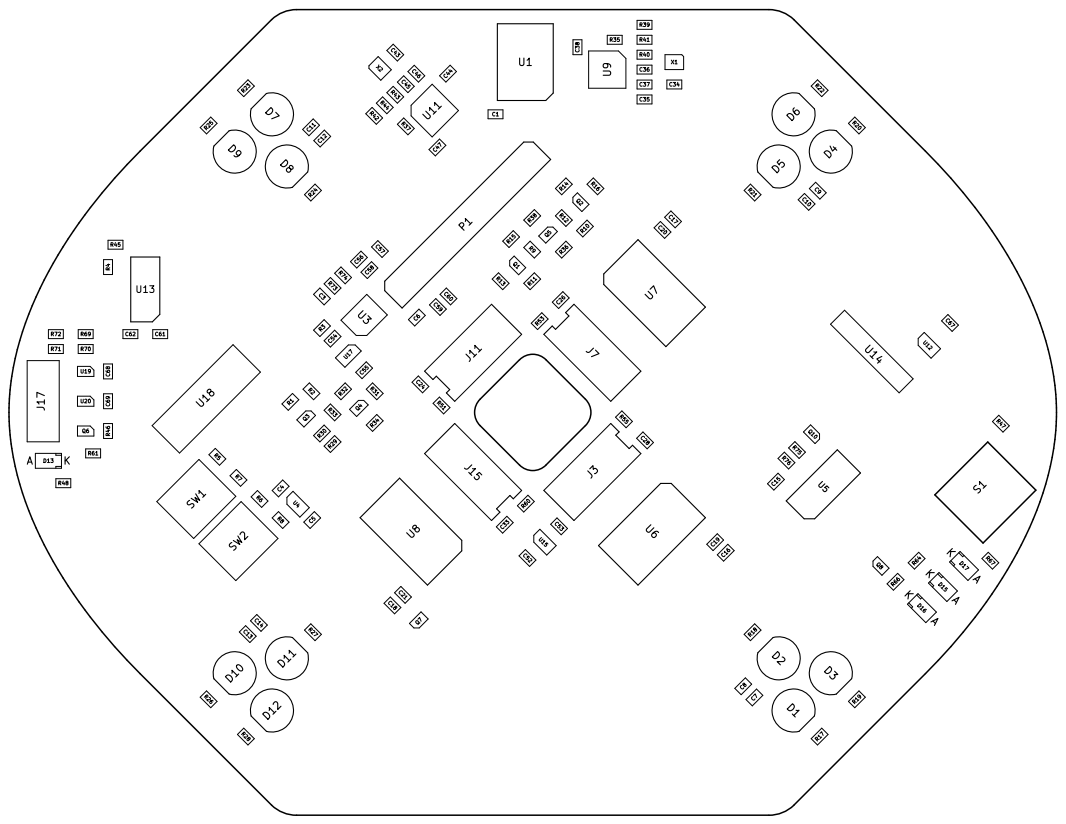
[picture p41: page 1]
