iridia-ulb/drone-pcb/(commit log)

2020-01-14 Add project layout
    [drone.kicad_pcb, drone.sch]
2020-01-15 Fixed 100 pin expansion header and added it to the schematic.
    [drone.sch]
2020-01-16 Add USB3503 (HSIC USB Hub)
    [drone.sch]
2020-01-16 Added USB Hub (USB2512B)
    [drone.sch]
2020-01-21 Added hierarchical sheet for the USB circuitry
    [drone.sch, usb.sch]
2020-01-22 added the schematic symbols for D36V28F3 and D36V50F5
2020-01-23 added the footprints and 3d models
2020-01-27 Split the hubs onto two sub-schematics
    [drone.sch, hsic-hub.sch, usb-hub.sch, usb.sch]
2020-01-27 Updated schematics
    [drone.sch, hsic-hub.sch]
2020-01-27 connected the USB3503 to the TPS2044 switch (incomplete)
    [drone.sch, hsic-hub.sch]
2020-01-28 Add a 38.4MHz crystal to project libraries.
    [astxr-12.step]
2020-01-28 fixed pull up connection
    [hsic-hub.sch]
2020-01-28 Add oscillator to HSIC hub circuit
    [hsic-hub.sch, usb-hub.sch]
2020-01-28 Add header for USB connector to libraries and schematic.
    [hsic-hub.sch, sm05b-srss-tb.step]
2020-01-28 added the LED driver circuit
    [led-driver.sch]
2020-01-28 added LED Driver sheet
    [drone.sch, hsic-hub.sch, led-driver.sch]
2020-01-29 Add symbols for the LED driver and LEDs to library.
    [drone.sch, led-driver.sch, leds.sch]
2020-01-29 Add TPS2054D and update HSIC schematic.
    [hsic-hub.sch]
2020-01-29 Minor adjustments to symbol library and HSIC schematic
    [hsic-hub.sch]
2020-01-29 added battery connector
    [XT60PW-M.STEP, drone.sch]
2020-01-31 Multiple updates. 1. Add MOSFETs to libraries 2. Update HSIC schematic to include level shifting
    [hsic-hub.sch]
2020-01-31 added CMX60D20 symbol and footprint
    [drone.sch]
2020-01-31 Add I2C level shifting and the two HSIC hubs.
    [drone.sch, hsic-hub0.sch, hsic-hub1.sch, leds.sch]
2020-01-31 added controlled motor driver connection
    [drone.sch, leds.sch]
2020-02-03 Added the power schematic. Made CMX60D20 symbol more compact.
    [drone.sch, hsic-hub0.sch, hsic-hub1.sch, leds.sch, power.sch]
2020-02-03 Clean up top level schematic.
    [drone.sch]
2020-02-03 fixed XT60PW-M symbol
    [power.sch]
2020-02-03 Add ToF schematic and components.
    [drone.sch, hsic-hub0.sch, hsic-hub1.sch, leds.sch, power.sch, tof-sensors.sch]
2020-02-03 Fix cache.
    [drone.sch, power.sch]
2020-02-03 added voltage regulators and FT231XS to drone library
    [drone.sch, leds.sch, power.sch]
2020-02-04 Added GPIO expander for hub signals.
    [drone.sch, hsic-hub0.sch, hsic-hub1.sch, tof-sensors.sch]
2020-02-04 Add labels for power.sch.
    [drone.sch, leds.sch, power.sch]
2020-02-04 added connectors symbols and footprints
    [power.sch]
2020-02-04 added 1.8V and 2.8V LDOs
    [drone.sch, hsic-hub0.sch, hsic-hub1.sch, leds.sch, power.sch]
2020-02-05 added missing 3d models and other minor changes
    [CMX60D20.step, XT60-F_Vertical.step, XT90PW-M.step, power.sch]
2020-02-06 Add Schmitt-trigger to libraries.
    [drone.sch, power.sch]
2020-02-10 Update schmitt trigger symbols.
    [drone.sch]
2020-02-10 Add power and reset switches
    [drone.sch]
2020-02-10 Add EEPROM to libraries and schematic.
    [drone.sch]
2020-02-10 Use 0805 for all capacitors and resistors.
    [drone.sch, hsic-hub0.sch, hsic-hub1.sch, leds.sch, power.sch, tof-sensors.sch]
2020-02-10 added footprint and 3d model of UP board socket
    [axk5s00347y.stp]
2020-02-10 Added footprint, model etc. for push buttons.
    [B3FS_1000.step, drone.sch]
2020-02-10 Update capacitor values.
    [tof-sensors.sch]
2020-02-10 added level shifters
    [power.sch]
2020-02-11 new D36V28F3 with socket and header
2020-02-11 Updates to schematic library and power circuitry.
    [drone.sch, power.sch]
2020-02-11 added spacers, pinheaders, and sockets to D36V50F5 and D36V28F3 footprints
    [PinHeader_1x05_P2.54mm_Vertical.step, PinHeader_2x06_P2.54mm_Vertical.step, PinSocket_1x05_P2.54mm_Vertical_SMD_Pin1Left.step, PinSocket_2x06_P2.54mm_Vertical_SMD.step, Spacer M2 M F 10mm.stp]
2020-02-12 added ES02MSABE footprint and 3d model
    [ES01MSABE.stp, ES02MSABE.stp]
2020-02-12 edited D36V28F3 and D36V50F5 mounting holes
2020-02-12 Minor tweaks to schematics.
    [drone.sch, power.sch]
2020-02-13 Finalized power schematic.
    [drone.sch, power.sch]
2020-02-13 added JST_GH_SM06B-GHS-TB connector symbol, footprint, and model
    [BM06B-GHS-TBT.STEP, SM06B-GHS-TB.STEP]
2020-02-14 Update the LEDs and resistor values. Add TELEM2 connector for Pixhawk.
    [MSL04.step, drone.sch, hsic-hub0.sch, hsic-hub1.sch, leds.sch]
2020-02-17 Minor fixes.
    [drone.sch, hsic-hub0.sch, hsic-hub1.sch, leds.sch]
2020-02-17 Major commit.
    1. Fixed errors in libraries
    2. Annoted schematics
    3. Imported board shape and components into Pcbnew
    [board-outline.dxf, drone.kicad_pcb, drone.sch, hsic-hub0.sch, hsic-hub1.sch, leds.sch, power.sch, sm07b-srss-tb.step]
2020-02-18 Add footprints and models
    [m2.5hex9mm.stp, vl53l0x-and-vl53l1x-carrier-model.step]
2020-02-18 Updated components and boardshape. Started layout.
    [drone.kicad_pcb, drone.sch]
2020-02-19 added cree LEDs
    [C503B.stp, leds.sch]
2020-02-19 minor edit
    [leds.sch]
2020-02-20 Update LED models, footprints, schematic, and PCB.
    [C503B.step, drone.kicad_pcb, leds.sch]
2020-02-20 Update PCB with new board shape
    [arms-outline.dxf, drone.kicad_pcb]
2020-02-20 Add board outline to Dwgs.User.
2020-02-20 Work in progress commit: some duplicate components in PCB.
    [drone.kicad_pcb, leds.sch]
2020-02-21 Major commit. Work in progress on board layout.
    [Spacer M2 M F 10mm.stp, drone.kicad_pcb, hsic-hub0.sch, leds.sch, m2-spacer-10mm.step, vertical-pin-header-1x05.step, vertical-pin-header-1x06.step, vertical-pin-socket-1x05.step]
2020-02-24 Work in progress on laying out the board.
    [arms-outline.dxf, arms.step, board-outline.dxf, drone.kicad_pcb, drone.sch, hsic-hub0.sch, hsic-hub1.sch, leds.sch]
2020-02-24 minor fix: renamed 1x06 -> 2x06
    [vertical-pin-header-2x06.step, vertical-pin-socket-2x06.step]
2020-02-24 minor fix 100cf -> 100n
    [leds.sch]
2020-02-25 Sync PCB with Mostafa's changes in 591300dce7c137266a5003d77d27599ba9f2b70b and 072953e29b5c6087e1b08c31e948b0a01f5166cc
    [drone.kicad_pcb]
2020-02-25 Many the minor updates.
    [7-188275-8.step, drone.kicad_pcb, hsic-hub0.sch, hsic-hub1.sch, tof-sensors.sch]
2020-02-26 Update layout
    [drone.kicad_pcb, drone.sch, hsic-hub0.sch, hsic-hub1.sch, leds.sch, power.sch, tof-sensors.sch]
2020-02-28 Add Xbee and AP2281 power switch to libaries.
    [NPPN101BFLC-RC.step, xbee.step]
2020-02-28 Add Xbee to schematics and PCB layout.
    [drone.kicad_pcb, power.sch]
2020-02-28 Work in progess on integrating the Xbee into the design.
    [drone.sch, power.sch]
2020-03-03 This commit introduces the Xbee as the central component in the system.
    [APT3216.step, drone.kicad_pcb, drone.sch, interface.sch, power.sch]
2020-03-04 Use standard names for differential pair nets.
    [hsic-hub0.sch, hsic-hub1.sch]
2020-03-04 Update footprints for MOSFETs. Starting I2C layout.
    [drone.kicad_pcb, drone.sch, interface.sch, tof-sensors.sch]
2020-03-05 Work in progress commit (component placement)
    [bolt-assembly.step, drone.kicad_pcb, hsic-hub1.sch, interface.sch, lower-components.step]
2020-03-06 Placement complete.
    [drone.kicad_pcb, drone.sch, leds.sch, tof-sensors.sch]
2020-03-06 Work in progress: routing I2C buses.
    [drone.kicad_pcb]
2020-03-09 Work in progress commit: routing (395 connections remaining)
    [drone.kicad_pcb]
2020-03-10 Work in progress commit: routing (230 connections remaining)
    [drone.kicad_pcb]
2020-03-11 Work in progress commit: routing (100 connections remaining)
    [drone.kicad_pcb]
2020-03-13 Work in progress commit: routing (43 connections remaining)
    [drone.kicad_pcb]
2020-03-16 Board routed, all DRC tests passed.
    [drone.kicad_pcb]
2020-03-17 Final checks complete.
    [drone.kicad_pcb]
2020-03-18 Show all layers in PCB
    [drone.kicad_pcb]
2020-03-18 Fix a few component values for the BOM
    [drone.kicad_pcb, drone.sch, interface.sch, tof-sensors.sch]
2020-03-23 Major commit 1. Moved a couple components and rerouted accordingly 2. Added fabrication information to all components 3. Several clean ups to footprints 4. Removed some unused components
    [XT60-F.step, XT60PW-M.STEP, drone.kicad_pcb, drone.sch, hsic-hub0.sch, hsic-hub1.sch, interface.sch, leds.sch]
2020-04-08 Remove phantom module
    [drone.kicad_pcb]
2020-04-08 Add SMD attribute to components without SMD pads so that they appear in the pick and place output
    [drone.kicad_pcb]
2020-06-17 Fix mistakes in footprints
2020-06-17 Update PCB with new footprints, reroute connections
    [drone.kicad_pcb]
2020-06-17 Tuned USB trace lengths
    [drone.kicad_pcb]
2020-06-19 Move COM_MUX_CTRL to DIO4
    [drone.kicad_pcb, interface.sch]
2020-06-19 Enable UART translator only after V18 becomes stable (>1.7V)
    [drone.kicad_pcb, drone.sch, interface.sch]
2020-06-19 Add anode and cathode mark to chip LEDs
    [drone.kicad_pcb]
2020-06-19 Update LED driver to operate at 5V
    [drone.kicad_pcb, drone.sch, leds.sch]
2020-06-20 Completed final checks
    [drone.kicad_pcb]
2020-06-20 Added manufacturing data to repository
    [BOM.xlsx, drone-bill-of-materials.xlsx, drone.kicad_pcb]
2021-05-05 Start PCB revision based on testing
    1. Split interface schematic into power and interface schematics
    2. Remove bi-directional level shifter for UART
    3. Connect 1V8 for the LEDs schematic
    4. Add new level-shifting buffer and USB hub components
    [drone.sch, hsic-hub0.sch, hsic-hub1.sch, interface.sch, leds.sch, power.sch, tof-sensors.sch]
2021-05-05 Import changes to PCB
    [drone.kicad_pcb]
2021-05-05 Add new level-translator/buffer to the interface circuit and import changes to PCB
    [drone.kicad_pcb, interface.sch]
2021-05-06 Start integrating the new USB hub
    1. Remove the two HSIC hubs
    2. Create a new schematic (usb.sch) that conserves the PMIC and connectors from the previous design
    3. Remove unused GPIO expander and replace with a GPIO-based reset line
    4. Add a 25 MHz oscillator for the new hub
    [asco.step, drone.kicad_pcb, drone.sch, hsic-hub0.sch, hsic-hub1.sch, interfaces.sch, leds.sch, power.sch]
2021-05-07 Add ferrite bead and POR supervisor for hub
    [drone.sch, usb.sch]
2021-05-07 Replace old components and related tracks, vias, etc on PCB with new components.
    [drone.kicad_pcb, drone.sch, usb.sch]
2021-05-13 Route remaining connections. Check schematics for errors.
    [drone.kicad_pcb, drone.sch, leds.sch, usb.sch]
2021-05-13 Update manufacturing directory to show the year
    [BOM.xlsx, drone-bill-of-materials.xlsx, drone.kicad_pcb]
2021-05-13 Tune differential pairs
    [drone.kicad_pcb]
2021-05-14 Include manufacturing data in version tracking
    [drone-pick-and-place.csv, pick-and-place.csv]
2021-05-14 Update fabrication layer, update footprints, and generate front and back assembly drawings
    [drone.kicad_pcb]
2021-05-14 First pass at preparing manufacturing data for May 2021
    [drone-bill-of-materials.xlsx, drone-pick-and-place.csv, drone.kicad_pcb]
2021-05-17 Update the manufacturing data for May 2021
    Improved tuning of a few USB traces
    Moved some traces further back from mounting holes to prevent damage
    [drone.kicad_pcb]
2021-05-21 Update BOM to request BetaLAYOUT to purchase components from TME
    [drone-bill-of-materials.xlsx]
2021-05-26 Refill zones
    [drone.kicad_pcb]
2021-06-04 Add the gerbers used for manufacturing
2021-11-12 Add PDFs for cables to the repository
